ultrazohm/uz_d_resolver/docs/uz_d_resolver_pinning.docx

CH A/1 | Signal Adapter Board | Signalrichtung aus Sicht FPGA IP-Core | Dig_IO Adapter Board | CPLD – Adapter Board Pin D5 | CPLD – FPGA-Seite D5
| N_SAMPLE | Out | 00 | 47 | Dig_06_Ch5
| SDI | Out (MOSI) | 01 | 56 | Dig_07_Ch5
| F_SYNC | Out | 02 | 41 | Dig_08_Ch5
| SCLK | Out | 03 | 58 | Dig_09_Ch5
| \RESET | Out | 04 | 42 | Dig_10_Ch5
| A1 | Out | 05 | 59 | Dig_11_Ch5
| A0 | Out | 06 | 43 | Dig_12_Ch5
| CS | Out | 07 | 60 | Dig_13_Ch5
| SDO | In (MISO) | 08 | 44 | Dig_14_Ch5
CH B/2 | Signal | | Dig_IO Adapter Board | CPLD – Adapter Board Pin D5 | CPLD – FPGA-Seite D5
| N_SAMPLE | Out | 09 | 61 | Dig_15_Ch5
| SDI | Out (MOSI) | 10 | 84 | Dig_16_Ch5
| F_SYNC | Out | 11 | 64 | Dig_17_Ch5
| SCLK | Out | 12 | 85 | Dig_18_Ch5
| \RESET | Out | 13 | 65 | Dig_19_Ch5
| A1 | Out | 14 | 86 | Dig_20_Ch5
| A0 | Out | 15 | 66 | Dig_21_Ch5
| CS | Out | 16 | 87 | Dig_22_Ch5
| SDO | In (MISO) | 17 | 67 | Dig_23_Ch5
CH C/3 | Signal | | Dig_IO Adapter Board | CPLD – Adapter Board Pin D5 | CPLD – FPGA-Seite D5
| N_SAMPLE | Out | 18 | - | -
| SDI | Out (MOSI) | 19 | - | -
| F_SYNC | Out | 20 | - | -
| SCLK | Out | 21 | - | -
| \RESET | Out | 22 | - | -
| A1 | Out | 23 | - | -
| A0 | Out | 24 | - | -
| CS | Out | 25 | - | -
| SDO | In (MISO) | 26 | - | -
