ultrazohm/uz_d_resolver/Data_Sheets/CN0276-DesignSupport/EVAL-CN0276-SDPZ-BOM-RevA.xlsx

Title: | CN0276 Bill of Materials
Rev: | 0
Date: | 07/10/2013
Quantity | Reference Designator(s) | Value | Package | Manufacturer | Manufacturer Part Number | Nashua Part Number
2 | C1-2 | 33p | 2012 | KEMET | C0805C330J5GACTU | 7000831
4 | C3-4 C16-17 | 3.9n | 2012 | KOA | NPO0805HTTD3R9J | 7000222
4 | C5-6 C12-13 | 120p | 2012 | muRata | GRM2165C2A121JA01 | .
4 | C7-8 C14-15 | 680p | 2012 | AVX | 08055A681FAT2A | 7000186
1 | C10 | 10n | 2012 | AVX | 08051C103KAT2A | 7000032
6 | C11 C35 C40 C50 C52 C54 | 10u | 2012 | TDK | C2012X5R1V106M125AC | .
2 | C18 C32 | 470p | 2012 | muRata | GRM2165C2A471JA01 | .
2 | C21 C26 | 2.7n | 2012 | TDK | C2012C0G1H272J060AA | .
16 | C22-24 C30-31 C34 C36-37 C39 C41-42 C44-46 C51 C9 | 100n | 2012 | Yageo | CC0805KRX7R8BB104 | 7000758
1 | C38 | 100u | 7343 | AVX | TAJE107M025RNJ | .
2 | C25 C28 | 470u | 7343 | VISHAY | TR3D477M6R3C0200 | 7001327
2 | C20 C29 | 56p | 2012 | muRata | GRM21A5C2E560JW01D | .
2 | C33 C19 | 2.2n | 2012 | TDK | C2012C0G1H222J085AA | .
6 | C43 C27 C47-49 C53 | 1u | 2012 | AVX | 0805ZC105KAT2A | 7000264
2 | D1-2 |  | 2012 | Lumex | SML-LXT0805GW-TR | 7001182
1 | D3 |  | 2012 | Kingbright | APT2012QBC/D | .
1 | D4 |  | 2012 | Kingbright | APT2012SYCK | .
2 | D5-6 |  | 2012 | Avago | HSMS-C170 | 7001059
1 | J1 |  | FX8-120S-SV | HIROSE | FX8-120S-SV | 6000923
1 | J2 |  | IDC20 | Tyco Electronics | 2-1634688-0 | .
1 | J3 |  | 2510-6PIN | Tyco Electronics | 640456-6 | .
1 | J4 |  | 301-2PIN | Weidmüller | PM 5.08/02/90 | 6001003
1 | L1 | 1k | 2012 | TDK | MMZ2012R102A | .
4 | R1 R11 R24 R33 | 4.7k | 2012 | KOA | RK73B2ATTDD472J | 7000044
8 | R5 R2-3 R25-28 R4 | 27k | 2012 | VISHAY | CRCW080527K0FK | .
5 | R7 R6 R16 R47 R57 | 10k | 2012 | KOA | RK73B2ATTD103J | 7000039
1 | R13 | NP
4 | R14-15 R29 R32 | 2k | 2012 | VISHAY | CRCW08052K00FK | 7001433
4 | R30-31 R17-18 | 1.2k | 2012 | KOA | RK73B2ATTDD122J | 7000249
1 | R19 | 100k | 2012 | VISHAY | CRCW0805100KFK | .
5 | R20 R23 R12 R10 R58 | 0 | 2012 | Panasonic | ERJ-6GEY0R00V | 7000228
4 | R8-9 R21-22 | 22k | 2012 | KOA | RK73B2ATTDD223J | 7000095
6 | R34-39 | 1k | 2012 | Yageo | RC0805JR-071KL | 7000554
2 | R40 R56 | 3.3k | 2012 | VISHAY | CRCW08053K30FK | .
2 | R41 R54 | 750 | 2012 | KOA | RK73B2ATTDD751J | 7000162
2 | R43 R52 | 6.2k | 2012 | VISHAY | CRCW08056K20FK | .
2 | R45 R51 | 910 | 2012 | VISHAY | CRCW0805910RFK | .
2 | R46 R48 | 820 | 2012 | VISHAY | CRCW0805820RFK | .
1 | R49 | 390 | 2012 | VISHAY | CRCW0805390RFK | .
4 | R50 R44 R53 R42 | 20k | 2012 | VISHAY | CRCW080520K0FK | .
1 | R55 | 1.6k | 2012 | VISHAY | CRCW08051K60FK | .
1 | U1 |  | SOIC-8 | Microchip | 24LC32A-I/SN | 1000614
2 | U2 U5 |  | SOIC-14 | Analog Devices, Inc. | AD8694ARZ | .
1 | U3 |  | TSSOP-16 | Analog Devices, Inc. | ADG1611BRUZ | .
1 | U4 |  | LQFP-48 | Analog Devices, Inc. | AD2S1210BSTZ | .
1 | U6 |  | SOIC-8 | Analog Devices, Inc. | AD8692ARZ | .
1 | U7 |  | SOIC-EP-8 | Analog Devices, Inc. | AD8397ARDZ | 30-025792-01
1 | U8 |  | TSSOP-16 | Analog Devices, Inc. | ADG1612BRUZ | .
1 | U9 |  | SOT-23-3 | Analog Devices, Inc. | ADM6328-22ARTZ-R7 | .
1 | U10 |  | SOIC-EP-8 | Analog Devices, Inc. | ADP7104ARDZ-5.0-R7 | 30-026221-01
1 | U11 |  | SOIC-EP-8 | Analog Devices, Inc. | ADP7104ARDZ-3.3-R7 | 30-026222-01
1 | U12 |  | SOT-23-3 | VISHAY | SI2343CDS | 1000351
1 | Y1 | 8.192M | HCM49 | TXC | 9C-8.192MAAJ-T | .
