ultrazohm/uz_d_resolver/Data_Sheets/EVAL-AD2S1210_Design_Files/EVAL-AD2S1210SDZ BOM Rev B.xlsx

Analog Bill Of Materials for EVAL-AD2S1210SDZ RevB.pcb on 05-June-14
Name | Part Description | Value | Tolerance | PCB Decal | SMD | Layer Name | PART DESC | MFG #1 | Part Number | STOCK CODE
A | LED-0603-GREEN | GREEN |  | LED-0603 | Yes | Top | LED, SMD Green | OSRAM | LGQ971 | Digikey 475-1409-1-ND
B | LED-0603-GREEN | GREEN |  | LED-0603 | Yes | Top | LED, SMD Green | OSRAM | LGQ971 | Digikey 475-1409-1-ND
C1 | CAP | 120pF |  | 603 | Yes | Top | CAPACITOR, 0603, 120PF, 50V | YAGEO (PHYCOMP) | CC0603JRNPO9BN121 | FEC 722-091
C2 | CAP | 1uF 12mR | 0.1 | C0805 | Yes | Top | CAPACITOR CERAMIC, 1UF, 16V, X7R, 0805 | TAIYO YUDEN | EMK212B7105KD-T | FEC 1683651
C3 | CAP | 10nF | 0.05 | C0402 | Yes | Top | MLCC, 0402, X7R, 16V, 10NF | MULTICOMP | MCCA000040 | FEC 1758885
C4 | CAP+ | 10uF | ±10% | RTAJ_B | Yes | Top | 20V Tantalum Capacitor 10UF B-Size | Vishay Sprague | 293D106X9020B2TE3 | FEC 1754203
C5 | CAP | 0.1uF | ±10% | C0603 | Yes | Top | 50V X7R Ceramic Capacitor | Murata | GRM188R71H104KA93D | FEC 8820023
C6 | CAP | 120pF |  | 603 | Yes | Top | CAPACITOR, 0603, 120PF, 50V | YAGEO (PHYCOMP) | CC0603JRNPO9BN121 | FEC 722-091
C7 | CAP | 22pF | 0.05 | C0603 | Yes | Top | CAPACITOR, 0603, 22PF, 50V | Yageo | CC0603JRNPO9BN220 | FEC 722005
C8 | CAP | 22pF | 0.05 | C0603 | Yes | Top | CAPACITOR, 0603, 22PF, 50V | Yageo | CC0603JRNPO9BN220 | FEC 722005
C9 | CAP | 1uF 12mR | 0.1 | C0805 | Yes | Top | CAPACITOR CERAMIC, 1UF, 16V, X7R, 0805 | TAIYO YUDEN | EMK212B7105KD-T | FEC 1683651
C10 | CAP | 10nF | 0.05 | C0402 | Yes | Top | MLCC, 0402, X7R, 16V, 10NF | MULTICOMP | MCCA000040 | FEC 1758885
C11 | CAP | 10nF | 0.05 | C0402 | Yes | Top | MLCC, 0402, X7R, 16V, 10NF | MULTICOMP | MCCA000040 | FEC 1758885
C12 | CAP+ | 10uF | ±10% | RTAJ_B | Yes | Top | 20V Tantalum Capacitor 10UF B-Size | Vishay Sprague | 293D106X9020B2TE3 | FEC 1754203
C13 | CAP | 10nF | 0.05 | C0402 | Yes | Top | MLCC, 0402, X7R, 16V, 10NF | MULTICOMP | MCCA000040 | FEC 1758885
C14 | CAP+ | 10uF | ±10% | RTAJ_B | Yes | Top | 20V Tantalum Capacitor 10UF B-Size | Vishay Sprague | 293D106X9020B2TE3 | FEC 1754203
C15 | CAP | DNP | tba | C0805 | Yes | Top | SMD Capacitor footprint | n/a | n/a | Do Not Place
C16 | CAP | 10nF | 0.05 | C0402 | Yes | Top | MLCC, 0402, X7R, 16V, 10NF | MULTICOMP | MCCA000040 | FEC 1758885
C17 | CAP | 0.1uF | ±10% | C0603 | Yes | Top | 50V X7R Ceramic Capacitor | Murata | GRM188R71H104KA93D | FEC 8820023
C18 | CAP | 0.1uF | ±10% | C0603 | Yes | Top | 50V X7R Ceramic Capacitor | Murata | GRM188R71H104KA93D | FEC 8820023
C19 | CAP | 0.1uF | ±10% | C0603 | Yes | Top | 50V X7R Ceramic Capacitor | Murata | GRM188R71H104KA93D | FEC 8820023
C20 | CAP | 0.1uF | ±10% | C0603 | Yes | Top | 50V X7R Ceramic Capacitor | Murata | GRM188R71H104KA93D | FEC 8820023
C21 | CAP | 0.1uF | ±10% | C0603 | Yes | Top | 50V X7R Ceramic Capacitor | Murata | GRM188R71H104KA93D | FEC 8820023
C22 | CAP | 0.1uF | ±10% | C0603 | Yes | Top | 50V X7R Ceramic Capacitor | Murata | GRM188R71H104KA93D | FEC 8820023
C23 | CAP | 0.1UF | ±10% | C0603 | Yes | Top | 50V X7R Ceramic Capacitor | Murata | GRM188R71H104KA93D | FEC 8820023
C24 | CAP+ | 10uF | ±10% | RTAJ_B | Yes | Top | 20V Tantalum Capacitor 10UF B-Size | Vishay Sprague | 293D106X9020B2TE3 | FEC 1754203
C25 | CAP | 0.1uF | ±10% | C0603 | Yes | Top | 50V X7R Ceramic Capacitor | Murata | GRM188R71H104KA93D | FEC 8820023
C26 | CAP | 0.1uF | ±10% | C0603 | Yes | Top | 50V X7R Ceramic Capacitor | Murata | GRM188R71H104KA93D | FEC 8820023
C27 | CAP | DNP |  | C0805 | Yes | Top | SMD Capacitor footprint | n/a | n/a | Do Not Place
C28 | CAP | 10nF | 0.05 | C0402 | Yes | Top | MLCC, 0402, X7R, 16V, 10NF | Multicomp | MCCA000040 | FEC 1758885
C36 | CAP | 120pF |  | 603 | Yes | Top | CAPACITOR, 0603, 120PF, 50V | YAGEO (PHYCOMP) | CC0603JRNPO9BN121 | FEC 722-091
C37 | CAP | 120pF |  | 603 | Yes | Top | CAPACITOR, 0603, 120PF, 50V | YAGEO (PHYCOMP) | CC0603JRNPO9BN121 | FEC 722-091
C501 | CAP | 1uF 12mR | 0.1 | C0805 | Yes | Top | CAPACITOR CERAMIC, 1UF, 16V, X7R, 0805 | TAIYO YUDEN | EMK212B7105KD-T | FEC 1683651
C502 | CAP | 1uF 12mR | 0.1 | C0805 | Yes | Top | CAPACITOR CERAMIC, 1UF, 16V, X7R, 0805 | TAIYO YUDEN | EMK212B7105KD-T | FEC 1683651
C503 | CAP | 2u2F 14mR | 0.1 | C0805 | Yes | Top | CAPACITOR MLCC | TAIYO YUDEN | EMK212BJ225KG-T | FEC 1611955
C504 | CAP | 180pF | 5% | C0805 | Yes | Top | CAP CER 180PF 50V 5% NP0 0805 | Yageo | CC0805JRNP09BN181 | Digikey 311-1114-1-ND
C505 | CAP | 2n7F | 10% | C0805 | Yes | Top | MLCC, 0805, X7R, 50V, 2.7NF | MULTICOMP | MCCA000360 | FEC 1759237
C506 | CAP | 1uF | 0.1 | C0603 | Yes | Top | CAPACITOR, 0603, X5R, 10V, 1UF | MURATA | GRM188R61A105KA61D | FEC 1828798
C507 | CAP | 1uF | 0.1 | C0603 | Yes | Top | CAPACITOR, 0603, X5R, 10V, 1UF | MURATA | GRM188R61A105KA61D | FEC 1828798
C700 | CAP | 1uF 5.5mR | 10% | 1206 | Yes | Top | CAPACITOR, 1206, X7R, 50V, 1UF | MURATA | GRM31MR71H105KA88L | FEC 1828838
C701 | CAP | 10nF | 5% | C0402 | Yes | Top | MLCC, 0402, X7R, 16V, 10NF | MULTICOMP | MCCA000040 | FEC 1758885
C702 | CAP | 10nF | 5% | C0402 | Yes | Top | MLCC, 0402, X7R, 16V, 10NF | MULTICOMP | MCCA000040 | FEC 1758885
C703 | CAP | 10nF | 5% | C0402 | Yes | Top | MLCC, 0402, X7R, 16V, 10NF | MULTICOMP | MCCA000040 | FEC 1758885
C704 | CAP+ | 10UF | ±10% | RTAJ_B | Yes | Top | 20V Tantalum Capacitor 10UF B-Size | Vishay Sprague | 293D106X9020B2TE3 | FEC 1754203
C709 | CAP | 1uF | ±10% | C0805 | Yes | Top | CAPACITOR, 0805, 1UF, 50V, X7R | MURATA | GRM21BR71H105KA12L | FEC 1735541
C710 | CAP | DNP | n/a | C0402 | Yes | Top | 0402 Capacitor Location | n/a | n/a | Do Not Place
C711 | CAP+ | 10uF | ±10% | RTAJ_B | Yes | Top | 20V Tantalum Capacitor 10UF B-Size | Vishay Sprague | 293D106X9020B2TE3 | FEC 1754203
C712 | CAP+ | 10uF | ±10% | RTAJ_B | Yes | Top | 20V Tantalum Capacitor 10UF B-Size | Vishay Sprague | 293D106X9020B2TE3 | FEC 1754203
C713 | CAP | DNP | n/a | C0402 | Yes | Top | 0402 Capacitor Location | n/a | n/a | Do Not Place
C714 | CAP | DNP | n/a | C0402 | Yes | Top | 0402 Capacitor Location | n/a | n/a | Do Not Place
C715 | CAP | DNP | n/a | C0402 | Yes | Top | 0402 Capacitor Location | n/a | n/a | Do Not Place
C720 | CAP | 10nF | 5% | C0402 | Yes | Top | MLCC, 0402, X7R, 16V, 10NF | MULTICOMP | MCCA000040 | FEC 1758885
C721 | CAP | 1uF | ±10% | C0805 | Yes | Top | CAPACITOR, 0805, 1UF, 50V, X7R | Murata | GRM21BR71H105KA12L | FEC 1735541
C722 | CAP | 10nF | 5% | C0402 | Yes | Top | MLCC, 0402, X7R, 16V, 10NF | MULTICOMP | MCCA000040 | FEC 1758885
C723 | CAP | 10nF | 5% | C0402 | Yes | Top | MLCC, 0402, X7R, 16V, 10NF | MULTICOMP | MCCA000040 | FEC 1758885
C724 | CAP+ | 10uF 14mR | 20% | RTAJ_B | Yes | Top | CAPACITOR CERAMIC 10UF, 25V, X5R, 1206 | Taiyo Yuden | TMK316BJ106ML-T | FEC 2112857
C725 | CAP | 0.1uF | ±10% | C0603 | Yes | Top | 50V X7R Ceramic Capacitor | Murata | GRM188R71H104KA93D | FEC 8820023
CLKIN | SMB |  |  | SMB | No | Top | Straight PCB Mount SMB Jack - 50 Ohm | Tyco | 1-1337482-0 | Digikey J615-ND
D1 | DIODE |  |  | DIODE-0805 | Yes | Top | Small Signal Diode | Taiwan Semiconductor | TS4148 RY | FEC 815-0206
D2 | DIODE |  |  | DIODE-0805 | Yes | Top | Small Signal Diode | Taiwan Semiconductor | TS4148 RY | FEC 815-0206
D3 | DIODE |  |  | DIODE-0805 | Yes | Top | Small Signal Diode | Taiwan Semiconductor | TS4148 RY | FEC 815-0206
D4 | DIODE |  |  | DIODE-0805 | Yes | Top | Small Signal Diode | Taiwan Semiconductor | TS4148 RY | FEC 815-0206
D501 | MBRS130L | MBR130T1G | 0.05 | DO-214AA | Yes | Top | DIODE, SCHOTTKY, 1A, 30V, SOD-123 | ON SEMICONDUCTOR | MBR130T1G | FEC 1431045
D700 | DIODE-SCHOTTKY-30V-2A-B230A-13-F | 30V, 2A |  | DO-214AC | Yes | Top | DIODE,SCHOTTKY,30V,2A,SMA | DIODES INC. | B230A-13-F | FEC 1843686
D701 | ZENER-DIODE-MMSZ5245BT1G | BZT52 |  | SOD-123 | Yes | Top | DIODE, ZENER, 0.5W, 5.1V | VISHAY SEMICONDUCTOR | BZT52B5V1-V-GS08 | FEC 1617767
DIR | LED-0603-GREEN | GREEN |  | LED-0603 | Yes | Top | LED, SMD Green | OSRAM | LGQ971 | Digikey 475-1409-1-ND
DOS | LED-0603-GREEN | RED |  | LED-0603 | Yes | Top | LED, SMD Red | OSRAM | LSQ976 | Digikey 475-2512-2-ND
J2 | SDP-STANDARD-CONN |  |  | CON-120/FX8-120S-SV_W/S | No | Top | 120-way connector, 0.6mm pitch | Hirose | FX8-120S-SV(21) | FEC 1324660
J3 | HEADER26 |  |  | HEADER26 | No | Top | 26-Pin Header Location - Keep Holes free of solder | n/a | n/a | Do Not Insert
J4 | HEADER12 |  |  | HEADER12 | No | Top | 12 Pin (2x6) 0.1" Pitch Header | n/a | n/a | Do Not Insert
J5 | CON\POWER4 |  |  | CON\POWER4 | No | Top | TERMINAL BLOCK, PCB, 4WAY | LUMBERG | KRM 04 | FEC 1177877
J6 | CON\POWER |  |  | CON\POWER | No | Top | TERMINAL BLOCK, PCB, 2WAY | LUMBERG | KRM 02 | FEC 151785
J500 | CON\POWER |  |  | CON\POWER | No | Top | 2 Pin Terminal Block (5mm Pitch) | Camden | CTB5000/2 | FEC 151785
J701 | CON\POWER |  |  | CON\POWER | No | Top | 2 Pin Terminal Block (5mm Pitch) | Camden | CTB5000/2 | FEC 151785
J702 | CON\BARREL_SMD_2MM_KLDX-SMT2-0202-A |  |  | CON\BARREL_SMD_2MM_KLDX-SMT2-0202-A | No | Top | DC Power Connectors 2mm SMT POWER JACK | KYCON | KLDX-SMT2-0202-A | MOUSER 806-KLDX-SMT20202A
J703 | CON\POWER |  |  | CON\POWER | No | Top | 2 Pin Terminal Block (5mm Pitch) | Camden | CTB5000/2 | FEC 151785
J704 | CON\POWER |  |  | CON\POWER | No | Top | 2 Pin Terminal Block (5mm Pitch) | Camden | CTB5000/2 | FEC 151785
L501 | IND-6.8UH-LPS5030-682ML | 5.6uH | ±30% | IND-LPS5030-MODIFIED | Yes | Top | SMT power inductor 5.6 uH | Coilcraft | ME3220-562ML | Coilcraft ME3220-562MLB
L701 | IND-6.8UH-LPS5030-682ML | 6.8uH | ±30% | IND-LPS5030-MODIFIED | Yes | Top | CHOKE, POWER, 6X6X2MM, 6.8UH | PANASONIC | ELL6PG6R8N | FEC 1865660
LED702 | LED-0603-GREEN | GREEN |  | LED-0603 | Yes | Top | LED, SMD Green | OSRAM | LGQ971 | Digikey 475-1409-1-ND
LK1 | JUMPER-2 |  |  | LINK-2-R0603 | Yes | Top | 2 Way Link Option - Insert 0r in Position-B | Multicomp | MC 0.063W 0603 0R | FEC 9331662
LK2 | JUMPER-3 |  |  | LINK-3-R0603 | No | Top | 3 Way Link Option - Insert 0r in Position-C | Multicomp | MC 0.063W 0603 0R | FEC 9331662
LK3 | JUMPER-3 |  |  | LINK-3-R0603 | No | Top | 3 Way Link Option - Insert 0r in Position-C | Multicomp | MC 0.063W 0603 0R | FEC 9331662
LK4 | JUMPER-3 |  |  | JUMPER_3 | No | Top | 6 Pin (3x2) 0.1" Header & Shorting Block - Insert Shorting Block in Position-C | Harwin | M20-9983646 | FEC 1022244 & 150-411 (36 Pin Strip, Cut to Lenght)
LK5 | JUMPER-3 |  |  | JUMPER_3 | No | Top | 6 Pin (3x2) 0.1" Header & Shorting Block - Insert Shorting Block in Position-C | Harwin | M20-9983646 | FEC 1022244 & 150-411 (36 Pin Strip, Cut to Lenght)
LK6 | JUMPER-3 |  |  | JUMPER_3 | No | Top | 6 Pin (3x2) 0.1" Header & Shorting Block - Insert Shorting Block in Position-C | Harwin | M20-9983646 | FEC 1022244 & 150-411 (36 Pin Strip, Cut to Lenght)
LK7 | JUMPER-3 |  |  | JUMPER_3 | No | Top | 6 Pin (3x2) 0.1" Header & Shorting Block - Insert Shorting Block in Position-C | Harwin | M20-9983646 | FEC 1022244 & 150-411 (36 Pin Strip, Cut to Lenght)
LK9 | LINK-2-R0603 |  |  | LINK-2-R0603 | Yes | Top | 2 Way Link Option - Insert 0r in Position-A | Multicomp | MC 0.063W 0603 0R | FEC 9331662
LK10 | JUMPER-3 |  |  | JUMPER_3_INVTEXT | No | Top | 6 Pin (3x2) 0.1" Header & Shorting Block - Insert Shorting Block in Position-B | M20-9983646 | M20-9983646 | FEC 1022244 & 150-411 (36 Pin Strip, Cut to Lenght)
LK11 | JUMPER-3 |  |  | JUMPER_3_INVTEXT | No | Top | 6 Pin (3x2) 0.1" Header & Shorting Block - Insert Shorting Block in Position-B | Harwin | M20-9983646 | FEC 1022244 & 150-411 (36 Pin Strip, Cut to Lenght)
LK12 | JUMPER-3 |  |  | JUMPER_3_INVTEXT | No | Top | 6 Pin (3x2) 0.1" Header & Shorting Block - Insert Shorting Block in Position-B | Harwin | M20-9983646 | FEC 1022244 & 150-411 (36 Pin Strip, Cut to Lenght)
LK13 | JUMPER-3 |  |  | JUMPER_3_INVTEXT | No | Top | 6 Pin (3x2) 0.1" Header & Shorting Block - Insert Shorting Block in Position-B | Harwin | M20-9983646 | FEC 1022244 & 150-411 (36 Pin Strip, Cut to Lenght)
LK14 | JUMPER2\SIP3 |  |  | LINK-3P | No | Top | 3 Pin SIL Header & Shorting Link - Insert Shorting Block in Position-A | Harwin | M20-9990345 & M7567-05 | FEC 1022248 & 150410
LK15 | JUMPER2\SIP3 |  |  | LINK-3P | No | Top | 3 Pin SIL Header & Shorting Link - Insert Shorting Block in Position-A | Harwin | M20-9990345 & M7567-05 | FEC 1022248 & 150410
LK16 | JUMPER2\SIP3 |  |  | LINK-3P | No | Top | 3 Pin SIL Header & Shorting Link - Insert Shorting Block in Position-A | Harwin | M20-9990345 & M7567-05 | FEC 1022248 & 150410
LK17 | JUMPER2\SIP3 |  |  | LINK-3P | No | Top | 3 Pin SIL Header & Shorting Link - Insert Shorting Block in Position-A | Harwin | M20-9990345 & M7567-05 | FEC 1022248 & 150410
LK501 | JUMPER2\SIP3 |  |  | LINK-3P | No | Top | 3 Pin SIL Header & Shorting Link - Insert Shorting Block in Position-A | Harwin | M20-9990345 & M7567-05 | FEC 1022248 & 150410
LK701 | JUMPER2\SIP3 |  |  | LINK-3P | No | Top | 3 Pin SIL Header & Shorting Link - Insert Shorting Block in Position-A | Harwin | M20-9990345 & M7567-05 | FEC 1022248 & 150410
LK702 | JUMPER2\SIP3 |  |  | LINK-3P | No | Top | 3 Pin SIL Header & Shorting Link - Insert Shorting Block in Position-A | Harwin | M20-9990345 & M7567-05 | FEC 1022248 & 150410
LK703 | JUMPER2\SIP3 |  |  | LINK-3P | No | Top | 3 Pin SIL Header & Shorting Link - Insert Shorting Block in Position-A | Harwin | M20-9990345 & M7567-05 | FEC 1022248 & 150410
LOT | LED-0603-GREEN | RED |  | LED-0603 | Yes | Top | LED, SMD Red | OSRAM | LSQ976 | Digikey 475-2512-2-ND
NM | LED-0603-GREEN | GREEN |  | LED-0603 | Yes | Top | LED, SMD Green | OSRAM | LGQ971 | Digikey 475-1409-1-ND
Q1 | BC846B |  |  | SOT23 | Yes | Top | NPN Small signal Transistor | PHILIPS | BC846B | FEC 1081229
Q2 | BC856BLT1 |  |  | SOT23 | Yes | Top | PNP Small signal Transistor | PHILIPS | BC856B | FEC 1081243
Q3 | BC846B |  |  | SOT23 | Yes | Top | NPN Small signal Transistor | PHILIPS | BC846B | FEC 1081229
Q4 | BC856BLT1 |  |  | SOT23 | Yes | Top | PNP Small signal Transistor | PHILIPS | BC856B | FEC 1081243
Q5 | PDTB123ET |  |  | SC-59 | Yes | Top | NPN BRT TRANSISTOR, 50V, 10K/10KOHM, SC-59 | On Semiconductor | MUN2211T1G | FEC 1232166
Q6 | PDTB123ET |  |  | SC-59 | Yes | Top | NPN BRT TRANSISTOR, 50V, 10K/10KOHM, SC-59 | On Semiconductor | MUN2211T1G | FEC 1232166
Q7 | PDTB123ET |  |  | SC-59 | Yes | Top | NPN BRT TRANSISTOR, 50V, 10K/10KOHM, SC-59 | On Semiconductor | MUN2211T1G | FEC 1232166
Q8 | PDTB123ET |  |  | SC-59 | Yes | Top | NPN BRT TRANSISTOR, 50V, 10K/10KOHM, SC-59 | On Semiconductor | MUN2211T1G | FEC 1232166
Q9 | PDTB123ET |  |  | SC-59 | Yes | Top | NPN BRT TRANSISTOR, 50V, 10K/10KOHM, SC-59 | On Semiconductor | MUN2211T1G | FEC 1232166
Q10 | PDTB123ET |  |  | SC-59 | Yes | Top | NPN BRT TRANSISTOR, 50V, 10K/10KOHM, SC-59 | On Semiconductor | MUN2211T1G | FEC 1232166
Q11 | PDTB123ET |  |  | SC-59 | Yes | Top | NPN BRT TRANSISTOR, 50V, 10K/10KOHM, SC-59 | On Semiconductor | MUN2211T1G | FEC 1232166
Q12 | PDTB123ET |  |  | SC-59 | Yes | Top | NPN BRT TRANSISTOR, 50V, 10K/10KOHM, SC-59 | On Semiconductor | MUN2211T1G | FEC 1232166
Q501 | SI2304DDS-T1-GE3 |  |  | SOT23 | Yes | Top | MOSFET,N CH,30V,3.6A,DIODE,SOT23 | Vichay Siliconix | SI2304DDS-T1-GE3 | FEC 1858939
Q700 | NPN-BCX19 |  |  | SOT23 | Yes | Top | TRANSISTOR, NPN, SOT-23 | ON SEMICONDUCTOR | MMBT3904LT1G | FEC 1459100
Q701 | 2N7002 |  |  | SOT23 | Yes | Top | MOSFET N Transistor | STMICROELECTRONICS | 2N7002 | FEC 9512608
R1 | RES | 10K | 1% | R0603 | Yes | Top | RESISTOR, 10K, 0.063W, 1%, 0603 | MULTICOMP | MC 0.063W 0603 1% 10K | FEC 9330399
R2 | RES | 2k2 | 0.05 | R0603 | Yes | Top | RESISTOR, 0603 2K2 | MULTICOMP | MC 0.063W 0603 5% 2K2 | FEC 9331913
R3 | RES | 10k | 1% | R0603 | Yes | Top | RESISTOR, 10K, 0.063W, 1%, 0603 | MULTICOMP | MC 0.063W 0603 1% 10K | FEC 9330399
R4 | RES | 2k2 | 0.05 | R0603 | Yes | Top | RESISTOR, 0603 2K2 | Multicomp | MC 0.063W 0603 5% 2K2 | FEC 9331913
R5 | RES | 2k2 | 0.05 | R0603 | Yes | Top | RESISTOR, 0603 2K2 | MULTICOMP | MC 0.063W 0603 5% 2K2 | FEC 9331913
R6 | RES | 2k2 | 0.05 | R0603 | Yes | Top | RESISTOR, 0603 2K2 | Multicomp | MC 0.063W 0603 5% 2K2 | FEC 9331913
R7 | RES | 2k2 | 0.05 | R0603 | Yes | Top | RESISTOR, 0603 2K2 | Multicomp | MC 0.063W 0603 5% 2K2 | FEC 9331913
R8 | RES | 2k2 | 0.05 | R0603 | Yes | Top | RESISTOR, 0603 2K2 | MULTICOMP | MC 0.063W 0603 5% 2K2 | FEC 9331913
R9 | RES | 10K | 1% | 603 | Yes | Top | RESISTOR, 10K, 0.063W, 1%, 0603 | MULTICOMP | MC 0.063W 0603 1% 10K | FEC 9330399
R10 | RES | DNP |  | 603 | Yes | Top | 0603 Resistor footprint | n/a | n/a | Do Not Place
R11 | RES | DNP | n/a | R0603 | Yes | Top | 0603 Resistor footprint | n/a | n/a | Do Not Place
R12 | RES | 15k4 | 0.01 | 603 | Yes | Top | SMD Resistor | Multicomp | MC 0.063W 0603 1% 15K4 | FEC 117-0904
R13 | RES | 8K66 | 0.01 | 603 | Yes | Top | SMD Resistor | Multicomp | MC 0.063W 0603 1% 8K66 | FEC 117-0884
R14 | RES | 4R7 |  | 603 | Yes | Top | RESISTOR, 4R7, 0.063W, 1%, 0603 | MULTICOMP | MC0063W060314R7 | FEC 9331280
R15 | RES | 2K2 |  | R0603 | Yes | Top | RESISTOR, 0603 2K2 | MULTICOMP | MC 0.063W 0603 5% 2K2 | FEC 9331913
R16 | RES | 3R3 |  | 603 | Yes | Top | RESISTOR, 3R3, 0.063W, 1%, 0603 | MULTICOMP | MC0063W060313R3 | FEC 9331069
R17 | RES | 10k | 1% | R0603 | Yes | Top | RESISTOR, 10K, 0.063W, 1%, 0603 | MULTICOMP | MC 0.063W 0603 1% 10K | FEC 9330399
R18 | RES | 2K2 |  | R0603 | Yes | Top | RESISTOR, 0603 2K2 | MULTICOMP | MC 0.063W 0603 5% 2K2 | FEC 9331913
R19 | RES | DNP |  | 603 | Yes | Top | 0603 Resistor footprint | n/a | n/a | Do Not Place
R20 | RES | 15k4 | 0.01 | 603 | Yes | Top | SMD Resistor | Multicomp | MC 0.063W 0603 1% 15K4 | FEC 117-0904
R21 | RES | DNP | DNI | R0603 | Yes | Top | 0603 Resistor footprint | n/a | n/a | Do Not Place
R22 | RES | DNP | DNI | R0603 | Yes | Top | 0603 Resistor footprint | n/a | n/a | Do Not Place
R23 | RES | 0R | 0.01 | R0805 | Yes | Top | RESISTOR, 0805 0R0,0.1W | Multicomp | MC 0.1W 0805 0R | FEC 9333681
R24 | RES | 0R | 0.01 | R0805 | Yes | Top | RESISTOR, 0805 0R0,0.1W | Multicomp | MC 0.1W 0805 0R | FEC 9333681
R25 | RES | 0R | 0.01 | R0805 | Yes | Top | RESISTOR, 0805 0R0,0.1W | Multicomp | MC 0.1W 0805 0R | FEC 9333681
R26 | RES | 0R | 0.01 | R0805 | Yes | Top | RESISTOR, 0805 0R0,0.1W | Multicomp | MC 0.1W 0805 0R | FEC 9333681
R27 | RES | 8K66 | 0.01 | 603 | Yes | Top | SMD Resistor | Multicomp | MC 0.063W 0603 1% 8K66 | FEC 117-0884
R28 | RES | 100K | 0.01 | R0603 | Yes | Top | SMD Resistor | Multicomp | MC 0.063W 0603 1% 100K | FEC 9330402
R29 | RES | 100K | 0.01 | R0603 | Yes | Top | SMD Resistor | Multicomp | MC 0.063W 0603 1% 100K | FEC 9330402
R30 | RES | DNP |  | 603 | Yes | Top | 0603 Resistor footprint | n/a | n/a | Do Not Place
R31 | RES | 15k4 | 0.01 | 603 | Yes | Top | SMD Resistor | Multicomp | MC 0.063W 0603 1% 15K4 | FEC 117-0904
R32 | RES | 8K66 | 0.01 | 603 | Yes | Top | SMD Resistor | Multicomp | MC 0.063W 0603 1% 8K66 | FEC 117-0884
R39 | RES | DNP |  | 603 | Yes | Top | 0603 Resistor footprint | n/a | n/a | Do Not Place
R40 | RES | 15k4 | 0.01 | 603 | Yes | Top | SMD Resistor | Multicomp | MC 0.063W 0603 1% 15K4 | FEC 117-0904
R41 | RES | 8K66 | 0.01 | 603 | Yes | Top | SMD Resistor | Multicomp | MC 0.063W 0603 1% 8K66 | FEC 117-0884
R42 | RES | 10K | 1% | 603 | Yes | Top | RESISTOR, 10K, 0.063W, 1%, 0603 | MULTICOMP | MC 0.063W 0603 1% 10K | FEC 9330399
R44 | RES | 3R3 |  | 603 | Yes | Top | RESISTOR, 3R3, 0.063W, 1%, 0603 | MULTICOMP | MC0063W060313R3 | FEC 9331069
R45 | RES | 68k | 0.01 | R0603 | Yes | Top | Resistor | MULTICOMP | MC 0.063W 0603 1% 68K | FEC 9331468
R46 | RES | DNP | 0.01 | R0603 | Yes | Top | 0603 Resistor footprint | n/a | n/a | Do Not Place
R47 | RES | 4R7 |  | 603 | Yes | Top | RESISTOR, 4R7, 0.063W, 1%, 0603 | MULTICOMP | MC0063W060314R7 | FEC 9331280
R48 | RES | 4R7 |  | 603 | Yes | Top | RESISTOR, 4R7, 0.063W, 1%, 0603 | MULTICOMP | MC0063W060314R7 | FEC 9331280
R49 | RES | 10k | 1% | R0603 | Yes | Top | RESISTOR, 10K, 0.063W, 1%, 0603 | MULTICOMP | MC 0.063W 0603 1% 10K | FEC 9330399
R50 | RES | 0r | 0.01 | R0603 | Yes | Top | RESISTOR, 0603, 0R, 0.063W | Multicomp | MC 0.063W 0603 0R | FEC 933-1662
R51 | RES | DNP | 0.01 | R0603 | Yes | Top | 0603 Resistor footprint | n/a | n/a | Do Not Place
R52 | RES | 10k | 1% | R0603 | Yes | Top | RESISTOR, 10K, 0.063W, 1%, 0603 | MULTICOMP | MC 0.063W 0603 1% 10K | FEC 9330399
R53 | RES | 0r | 0.01 | R0603 | Yes | Top | RESISTOR, 0603, 0R, 0.063W | Multicomp | MC 0.063W 0603 0R | FEC 933-1662
R54 | RES | DNP | 0.01 | R0603 | Yes | Top | 0603 Resistor footprint | n/a | n/a | Do Not Place
R55 | RES | DNP | 0.01 | R0603 | Yes | Top | 0603 Resistor footprint | n/a | n/a | Do Not Place
R56 | RES | DNP | 0.01 | R0603 | Yes | Top | 0603 Resistor footprint | n/a | n/a | Do Not Place
R57 | RES | 0R | 0.01 | R0603 | Yes | Top | RESISTOR, 0603, 0R, 0.063W | Multicomp | MC 0.063W 0603 0R | FEC 933-1662
R58 | RES | 0r | 0.01 | R0603 | Yes | Top | RESISTOR, 0603, 0R, 0.063W | Multicomp | MC 0.063W 0603 0R | FEC 933-1662
R59 | RES | 0R | 0.01 | R0603 | Yes | Top | RESISTOR, 0603, 0R, 0.063W | Multicomp | MC 0.063W 0603 0R | FEC 933-1662
R60 | RES | DNP | 0.01 | R0603 | Yes | Top | 0603 Resistor footprint | n/a | n/a | Do Not Place
R61 | RES | DNP | 0.01 | R0603 | Yes | Top | 0603 Resistor footprint | n/a | n/a | Do Not Place
R62 | RES | 0R | 0.01 | R0603 | Yes | Top | RESISTOR, 0603, 0R, 0.063W | Multicomp | MC 0.063W 0603 0R | FEC 933-1662
R63 | RES | 0R | 0.01 | R0603 | Yes | Top | RESISTOR, 0603, 0R, 0.063W | Multicomp | MC 0.063W 0603 0R | FEC 933-1662
R64 | RES | DNP | 0.01 | R0603 | Yes | Top | 0603 Resistor footprint | n/a | n/a | Do Not Place
R65 | RES | 2K2 |  | R0603 | Yes | Top | RESISTOR, 0603 2K2 | MULTICOMP | MC 0.063W 0603 5% 2K2 | FEC 9331913
R66 | RES | 2K2 |  | R0603 | Yes | Top | RESISTOR, 0603 2K2 | MULTICOMP | MC 0.063W 0603 5% 2K2 | FEC 9331913
R67 | RES | 3R3 |  | 603 | Yes | Top | RESISTOR, 3R3, 0.063W, 1%, 0603 | MULTICOMP | MC0063W060313R3 | FEC 9331069
R68 | RES | 3R3 |  | 603 | Yes | Top | RESISTOR, 3R3, 0.063W, 1%, 0603 | MULTICOMP | MC0063W060313R3 | FEC 9331069
R74 | RES | 22K | 0.01 | R0603 | Yes | Top | RESISTOR, 22K, 0.063W, 1% | MULTICOMP | MC 0.063W 0603 1% 22K | FEC 9330828
R75 | RES | 10K | 1% | R0603 | Yes | Top | RESISTOR, 10K, 0.063W, 1%, 0603 | MULTICOMP | MC 0.063W 0603 1% 10K | FEC 9330399
R76 | RES | DNP | n/a | R0603 | Yes | Top | 0603 Resistor footprint | n/a | n/a | Do Not Place
R113 | RES | 4R7 |  | 603 | Yes | Top | RESISTOR, 4R7, 0.063W, 1%, 0603 | MULTICOMP | MC0063W060314R7 | FEC 9331280
R147 | RES | 0R | 0.01 | R0603 | Yes | Top | RESISTOR, 0603, 0R, 0.063W | Multicomp | MC 0.063W 0603 0R | FEC 933-1662
R148 | RES | 10k | 1% | R0603 | Yes | Top | RESISTOR, 10K, 0.063W, 1%, 0603 | MULTICOMP | MC 0.063W 0603 1% 10K | FEC 9330399
R165 | RES | DNP | 0.01 | R0603 | Yes | Top | 0603 Resistor footprint | n/a | n/a | Do Not Place
R501 | RES | 33mR | 0.02 | R0805 | Yes | Top | RESISTOR, CUR SENSE, 0.033OHM, 250mW, 2% | SUSUMU | RL1220T-R033-G | FEC 9376739
R502 | RES | 768R | 1% | R0805 | Yes | Top | RES 768 OHM 1/8W 1% 0805 SMD | Yageo | RC0805FR-07768RL | Digikey 311-768CRCT-ND
R503 | RES | 24k9 | 1% | R0805 | Yes | Top | RES 24.9K OHM 1/8W 1% 0805 SMD | Yageo | RC0805FR-0724K9L | Digikey 311-24.9KCRCT-ND
R504 | RES | 3k65 | 1% | R0805 | Yes | Top | RES 3.65K OHM 1/8W 1% 0805 SMD | Yageo | RC0805FR-073K65L | Digikey 311-3.65KCRCT-ND
R505 | RES | 75k | 0.01 | R0805 | Yes | Top | RESISTOR, 0805 75K | MULTICOMP | MC 0.1W 0805 1% 75K | FEC 9333541
R506 | RES | 8K45 | 0.01 | R0805 | Yes | Top | RESISTOR, THICK FILM, 8.45KOHM, 125mW, 1% | Vishay/Dale | CRCW08058K45FKEA | FEC 1270592
R507 | RES | 536R | 1% | R0805 | Yes | Top | RES 536 OHM 1/8W 1% 0805 SMD | Stackpole Electronics Inc | RMCF0805FT536R | Digikey RMCF0805FT536RCT-ND
R508 | RES | 1k54 | 1% | R0805 | Yes | Top | RES 1.54K OHM 1/8W 1% 0805 SMD | Yageo | RC0805FR-071K54L | Digikey 311-1.54KCRCT-ND
R509 | RES | 0R | 0.01 | R0805 | Yes | Top | RESISTOR, 0805 0R0,0.1W | Multicomp | MC 0.1W 0805 0R | FEC 9333681
R700 | RES0603 | 330k | 5% | R0402 | Yes | Top | RESISTOR, RC31 0402 330K | YAGEO (PHYCOMP) | RC0402JR-07330KL | FEC 9233067
R701 | RES | 68k | 5% | R0402 | Yes | Top | RESISTOR, 0402, 1%, 68K | YAGEO (PHYCOMP) | RC0402JR-0768KL | FEC 9232982
R702 | RES | 18k | 5% | R0402 | Yes | Top | RESISTOR, RC31 0402 18K | YAGEO (PHYCOMP) | RC0402JR-0718KL | FEC 9232915
R703 | RES | 68k | 5% | R0402 | Yes | Top | RESISTOR, 0402, 1%, 68K | YAGEO (PHYCOMP) | RC0402JR-0768KL | FEC 9232982
R704 | RES | 68k | 5% | R0402 | Yes | Top | RESISTOR, 0402, 1%, 68K | YAGEO (PHYCOMP) | RC0402JR-0768KL | FEC 9232982
R705 | RES | 18k | 5% | R0402 | Yes | Top | RESISTOR, RC31 0402 18K | YAGEO (PHYCOMP) | RC0402JR-0718KL | FEC 9232915
R706 | RES | 18k | 5% | R0402 | Yes | Top | RESISTOR, RC31 0402 18K | YAGEO (PHYCOMP) | RC0402JR-0718KL | FEC 9232915
R707 | RES | 68k | 5% | R0402 | Yes | Top | RESISTOR, 0402, 1%, 68K | YAGEO (PHYCOMP) | RC0402JR-0768KL | FEC 9232982
R708 | RES | 18k | 5% | R0402 | Yes | Top | RESISTOR, RC31 0402 18K | YAGEO (PHYCOMP) | RC0402JR-0718KL | FEC 9232915
R709 | RES | 61R9 | 1% | R0402 | Yes | Top | RESISTOR, 0402, 1%, 61R9 | MULTICOMP | MC 0.0625W 0402 1% 61R9 | FEC 1802915
R710 | RES | 470R | 5% | R0402 | Yes | Top | RESISTOR, 0402, 470R, 0,5% | YAGEO (PHYCOMP) | RE0402DR-07470RL | FEC 1840545
R711 | RES | 10k2 | 1% | R0402 | Yes | Top | SMD Resistor | Multicomp | MC 0.0625W 0402 1% 10K2 | FEC 1803137
R712 | RES0603 | 330k | 5% | R0402 | Yes | Top | RESISTOR, RC31 0402 330K | YAGEO (PHYCOMP) | RC0402JR-07330KL | FEC 9233067
R713 | RES | 2k4 | 1% | R0603 | Yes | Top | RESISTOR, THICK FILM, 2.4KOHM, 0603, 100mW, 1% | YAGEO | RC0603FR-072K4L | FEC 1799329
R714 | RES | 53k6 | 1% | R0402 | Yes | Top | SMD Resistor | Multicomp | MC 0.0625W 0402 1% 53K6 | FEC 1803723
R716 | RES | 10k | 1% | R0402 | Yes | Top | RESISTOR, 10K, 0.063W, 1%, 0402 | MULTICOMP | MC00625W0402110K | FEC 1358069
R717 | RES | 10k | 1% | R0402 | Yes | Top | RESISTOR, 10K, 0.063W, 1%, 0402 | MULTICOMP | MC00625W0402110K | FEC 1358069
R718 | RES | 10k | 1% | R0402 | Yes | Top | RESISTOR, 10K, 0.063W, 1%, 0402 | MULTICOMP | MC00625W0402110K | FEC 1358069
R719 | RES | 10k | 1% | R0402 | Yes | Top | RESISTOR, 10K, 0.063W, 1%, 0402 | MULTICOMP | MC00625W0402110K | FEC 1358069
RESET | SW-PUSH-SMD |  |  | SW_PB_SMD_6MM | Yes | Top | SMD Push Button Switch (sealed 6mm x 6mm) | Omron | B3S-1000 | FEC 177-807
S2 | SW-PUSH-SMD |  |  | SW_PB_SMD_6MM | Yes | Top | SMD Push Button Switch (sealed 6mm x 6mm) | Omron | B3S-1000 | FEC 177-807
S3 | SW-PUSH-SMD |  |  | SW_PB_SMD_6MM | Yes | Top | SMD Push Button Switch (sealed 6mm x 6mm) | Omron | B3S-1000 | FEC 177-807
T_AGND | TESTPOINT | Red |  | TESTPOINT | No | Top | TERMINAL, PCB, RED, PK100 | VERO | 20-313137 | FEC 8731144
T_COS | TESTPOINT | Red |  | TESTPOINT | No | Top | TERMINAL, PCB, RED, PK100 | VERO | 20-313137 | FEC 8731144
T_COSLO | TESTPOINT | Red |  | TESTPOINT | No | Top | TERMINAL, PCB, RED, PK100 | VERO | 20-313137 | FEC 8731144
T_DGND | TESTPOINT | Red |  | TESTPOINT | No | Top | TERMINAL, PCB, RED, PK100 | VERO | 20-313137 | FEC 8731144
T_EXC | TESTPOINT | Red |  | TESTPOINT | No | Top | TERMINAL, PCB, RED, PK100 | VERO | 20-313137 | FEC 8731144
T_EXC_OUT | TESTPOINT | Red |  | TESTPOINT | No | Top | TERMINAL, PCB, RED, PK100 | VERO | 20-313137 | FEC 8731144
T_REFOUT | TESTPOINT | Red |  | TESTPOINT | No | Top | TERMINAL, PCB, RED, PK100 | VERO | 20-313137 | FEC 8731144
T_SIN | TESTPOINT | Red |  | TESTPOINT | No | Top | TERMINAL, PCB, RED, PK100 | VERO | 20-313137 | FEC 8731144
T_SINLO | TESTPOINT | Red |  | TESTPOINT | No | Top | TERMINAL, PCB, RED, PK100 | VERO | 20-313137 | FEC 8731144
T_\EXC | TESTPOINT | Red |  | TESTPOINT | No | Top | TERMINAL, PCB, RED, PK100 | VERO | 20-313137 | FEC 8731144
T_\EXC_OUT | TESTPOINT | Red |  | TESTPOINT | No | Top | TERMINAL, PCB, RED, PK100 | VERO | 20-313137 | FEC 8731144
U1 | AD2S1210DSTZ |  |  | LQFP48 | Yes | Top | 10-16-Bit R/D Converter | Analog Devices | AD2S1210DSTZ | AD2S1210DSTZ
U2 | 24LC32A-I/MS |  |  | MSO8 | Yes | Top | 32K I2C Serial EEPROM, MSOP8 | Microchip | 24LC32A-I/MS | FEC 1331330
U3 | ADG3308BRUZ |  |  | TSSOP20 | Yes | Top | Bidirectional Logic Level Translator | Analog Devices | ADG3308BRUZ | ADG3308BRUZ
U4 | AD8397ARMZ |  |  | SO8NB | Yes | Top | Dual Op-Amp | Analog Devices | AD8397ARZ | AD8397ARZ
U5 | ADG3308BRUZ |  |  | TSSOP20 | Yes | Top | Bidirectional Logic Level Translator | Analog Devices | ADG3308BRUZ | ADG3308BRUZ
U8 | ADM811 |  |  | SOT143 | Yes | Top | Voltage Monitor | Analog Devices | ADM811-3TARTZ | ADM811-3TARTZ
U9 | AD8662 |  |  | SO8NB | Yes | Top | DUAL OP Amp | Analog Devices | AD8662ARZ | AD8662ARZ
U11 | ADG3308BRUZ |  |  | TSSOP20 | Yes | Top | Bidirectional Logic Level Translator | Analog Devices | ADG3308BRUZ | ADG3308BRUZ
U501 | ADP1621 |  |  | MSO10 | Yes | Top | Constant-Frequency, Current-Mode Step-Up DC/DC Controller | Analog Devices | ADP1621ARMZ | ADP1621ARMZ
U700 | ADP3303-5 |  |  | SO8NB | Yes | Top | Precision Low Dropout Voltage Regulator | Analog Devices | ADP3303AR-5 | ADI ADP3303ARZ-5
U703 | ADM1185ARMZ |  |  | MSO10 | Yes | Top | Quad Voltage Monitor and Sequencer | Analog Devices | ADM1185ARMZ-1 | ADI ADM1185ARMZ-1
U704 | ADP3303-5 |  |  | SO8NB | Yes | Top | Precision Low Dropout Voltage Regulator | Analog Devices | ADP3303AR-5 | ADI ADP3303ARZ-5
U705 | ADP2301AUJZ |  |  | TSOT-6 | Yes | Top | 1.2 A, 20 V, 1.4 MHz non-synchronous Step-down Switching Regulator | Analog Devices | ADP2301AUJZ | ADI ADP2301AUJZ-R7
X1 | CLAMP-7MM |  |  | CLAMP-7MM | No | Top | 7mm QFP Clamp | IM Tech | CLAMP-7MM | Do Not Insert
Y1 | XTAL1 | 8.192MHz |  | XTAL-UM1 | No | Top | Crystal | AEL | X8M192000L123 | FEC 9509453
Screw1 |  | ** |  |  |  |  | SCREW, CHEESE, NYLON, M3X10, PK100 | ALLTHREAD | 119030010 | FEC 7070597
Screw2 |  | ** |  |  |  |  | SCREW, CHEESE, NYLON, M3X10, PK100 | ALLTHREAD | 119030010 | FEC 7070597
Nut1 |  | ** |  |  |  |  | NUT/WASHER, NYLON, M3, PK100 | DURATOOL | 1140030 | FEC 7061857
Nut2 |  | ** |  |  |  |  | NUT/WASHER, NYLON, M3, PK100 | DURATOOL | 1140030 | FEC 7061857
 | Distributor Web Sites |  |  |  |  | Parts Not Inserted
 | FEC | www.farnell.com |  |  |  | ADI Supplied Parts
 | Digikey | www.digikey.com |  |  |  | Changes since last Rev
 | Analog Devices | www.analog.com |  |  |  | Bare Board |  | EVAL-AD2S1210SDZ RevB
 | Anixter Comps | www.anixtercomponents.com |  |  |  | 4 x Stick on feet - height must be greater than component height on Bottom side Do Not Cover Mounting holes with Feet. |  | 3M | SJ5008BLACK | FEC 1165072
 | Coilcraft | www.coilcraft.com |  |  |  | Packing Material |  |  |  | Bubble Wrap
 |  |  |  |  |  | Board to be placed in suitable sized Anti-static bag
 |  |  |  |  |  | Eval Kit Box - Large |  |  |  | ADLK Stores 64005043
 |  |  |  |  |  | 9Vdc 2Amp Plug & Go 18 Watt Interchangeable SMPSU |  | Stontronics | T4817ST | ADI 22001001
 |  |  |  |  |  | Distribution CD - check latest revision |  |  |  | ADI Issue
 |  |  |  |  |  | BOX LABELS |  | Part No: EVAL-AD2S1210SDZ Description: AD2S1210SDZ Evaluation Kit |  | ADI Issue
** Fit both screws from the opposite side of the board to the 120-way connector, into the two associated connector mounting holes and fix securely in place with nuts .
