ultrazohm/uz_d_resolver/Project Outputs for UZ_D_Resolver/Rev02/BOM/BOM_JLC-UZ_D_Resolver_August_2024.xlsx

Quantity | Comment | Designator | Manufacturer | Value | Description | Footprint | Voltage | Dielectric | Manufacturer Part Number | LCSC Part Number
12 | 4.7 µF | C1A, C1B, C1C, C6A, C6B, C6C, C8A, C8B, C8C, C9A, C9B, C9C | muRata | 4.7 µF | Capacitor 0603, 35 VDC, 4.7 µF, X5R | C_0603 |  |  | GRM188R6YA475KE15D | C19666
12 | 10 nF | C2A, C2B, C2C, C5A, C5B, C5C, C7A, C7B, C7C, C10A, C10B, C10C | FH (Guangdong Fenghua Advanced Tech) | 10 nF | 50V 10nF X7R ±10% 0603 Multilayer Ceramic Capacitors MLCC - SMD/SMT ROHS | C_0603 |  |  | 0603B103K500NT | C57112
1 | 100 nF | C3 | KEMET | 100 nF | Capacitor 0603, 6.3 VDC, 100 nF, X5R | C_0603 |  |  | C0603C104K9PACTU | C14663
12 | 100 nF | C4A, C4B, C4C, C12A, C12B, C12C, C24A, C24B, C24C, C29A, C29B, C29C | YAGEO | 100 nF | Capacitor 0603, 50 VDC, 100 nF, X7R | C_0603 |  |  | CC0603KRX7R9BB104 | C14663
9 | 2.2uF | C11A, C11B, C11C, C13A, C13B, C13C, C30A, C30B, C30C |  | 2.2uF | Capacitor | RES_1206 | 50V |  |  | C50254
18 | 100 pF | C14A, C14B, C14C, C15A, C15B, C15C, C16A, C16B, C16C, C17A, C17B, C17C, C18A, C18B, C18C, C19A, C19B, C19C | Samsung Electro-Mechanics | 100 pF | 50V 100pF C0G ±5% 0603 Multilayer Ceramic Capacitors MLCC - SMD/SMT ROHS | C_0603 |  |  | CL10C101JB8NNNC | C14858
24 | 1 nF | C20A, C20B, C20C, C21A, C21B, C21C, C22A, C22B, C22C, C23A, C23B, C23C, C25A, C25B, C25C, C26A, C26B, C26C, C27A, C27B, C27C, C28A, C28B, C28C | YAGEO | 1 nF | Capacitor 0603, 50 VDC, 1 nF, NP0 | C_0603 |  |  | CC0603JRNPO9BN102 | C106246
1 | 19-217/BHC-ZL1M2RY/3T | D1 | Everlight Elec |  | LED BLUE 465~475NM 11.5~28.5MCD@5MA TOP VIEW 0603 ROHS | WL-SMCW_0603 |  |  | 19-217/BHC-ZL1M2RY/3T | C434421
3 | KT-0603R | D2A, D2B, D2C | Hubei KENTO Elec |  | LED RED 520~625NM 90~100MCD@20MA TOP VIEW 0603 ROHS | WL-SMCW_0603 |  |  | KT-0603R | C2286
3 | 19-217/GHC-YR1S2/3T | D3A, D3B, D3C | Everlight Elec |  | LED GREEN 520~535NM 112~258MCD@20MA TOP VIEW 0603 ROHS | WL-SMCW_0603 |  |  | 19-217/GHC-YR1S2/3T | C72043
6 | BAV99,235 | D4A, D4B, D4C, D5A, D5B, D5C |  |  | DIODE ARRAY GP 100V 215MA SOT23 | SOT-23 |  |  |  | C2500
12 | SBAS70-04LT1G | D6A, D6B, D6C, D7A, D7B, D7C, D8A, D8B, D8C, D9A, D9B, D9C |  |  | DIODE SCHOTTKY 70V DUAL SOT23 | SOT-23 |  |  |  | C389351
7 | Littelfuse_PTC_1812 | F1, F2A, F2B, F2C, F3A, F3B, F3C | Littelfuse | PTC, 1.1 A, 24V | POLYSWITCH RESETTABLE DEVICES | 1812_PTC_Polyfuse_Littelfuse | 24V |  | Littelfuse_PTC_1812 | C70119
6 | UPZ2012E601-2R0TF | L1A, L1B, L1C, L2A, L2B, L2C | Sunlord | 90 Ohm | 2A 1 90mΩ 600Ω@100MHz ±25% 0805 Ferrite Beads ROHS | INDC2012X92N_V |  |  | UPZ2012E601-2R0TF | C98308
6 | BC846BLT3G | Q1A, Q1B, Q1C, Q3A, Q3B, Q3C |  |  | NPN Bipolar Transistor | SOT-23 |  |  |  | C513271
6 | BC856B,215 | Q2A, Q2B, Q2C, Q4A, Q4B, Q4C |  |  | PNP Bipolar Transistor | SOT-23 |  |  |  | C109310
9 | 0R | R2, R50A, R50B, R50C, R52A, R52B, R52C, R53, R54 | YAGEO | 0R | SMD resistor E24 series | RES 0603_1608 |  |  | RC0603JR-070RL | C21189
4 | 22k | R6, R24A, R24B, R24C | KOA Speer | 22k | SMD resistor E24 series | RES 0603_1608 |  |  | RK73B1JTTD223J | C31850
33 | 10k | R8A, R8B, R8C, R9A, R9B, R9C, R12A, R12B, R12C, R13A, R13B, R13C, R16A, R16B, R16C, R18A, R18B, R18C, R20A, R20B, R20C, R21A, R21B, R21C, R25A, R25B, R25C, R26A, R26B, R26C, R27A, R27B, R27C | KOA Speer | 10k | SMD resistor E24 series | RES 0603_1608 |  |  | RK73B1JTTD103J | C25804
17 | 4k7 | R22A, R22B, R22C, R46A, R46B, R46C, R47A, R47B, R47C, R48A, R48B, R48C, R49A, R49B, R49C, R55, R56, R57 | UNI-ROYAL | 4k7 | SMD resistor E24 series | RES 0603_1608 |  |  | 0603WAF4701T5E | C23162
15 | 2k2 | R23A, R23B, R23C, R30A, R30B, R30C, R33A, R33B, R33C, R34A, R34B, R34C, R37A, R37B, R37C | KOA Speer | 2k2 | SMD resistor E24 series | RES 0603_1608 |  |  | RK73B1JTTD222J | C4190
6 | 15k | R28A, R28B, R28C, R29A, R29B, R29C | KOA Speer | 15k | SMD resistor E24 series | RES 0603_1608 |  |  | RK73B1JTTD153J | C22809
12 | 3.3R | R31A, R31B, R31C, R32A, R32B, R32C, R35A, R35B, R35C, R36A, R36B, R36C | KOA Speer | 3.3R | SMD resistor E24 series | RES 0603_1608 |  |  | RK73B1JTTDD3R3J | C25238
12 | 4.7R | R38A, R38B, R38C, R39A, R39B, R39C, R40A, R40B, R40C, R41A, R41B, R41C | KOA Speer | 4.7R | SMD resistor E24 series | RES 0603_1608 |  |  | RK73B1JTTDD4R7J | C23164
12 | 100R | R42A, R42B, R42C, R43A, R43B, R43C, R44A, R44B, R44C, R45A, R45B, R45C | KOA Speer | 100R | SMD resistor E24 series | RES 0603_1608 |  |  | RK73B1JTTD101J | C22775
2 | 100k | R59, R60 | KOA Speer | 100k | SMD resistor E24 series | RES 0603_1608 |  |  | RK73B1JTTD104J | C25803
1 | Serial # | Serial | PCB Manufacturer |  | Field to put in a serial number | SERIAL |  |  | Serial Number |  | old part
3 | AD2S1210 | U1A, U1B, U1C |  | AD2S1210WDSTZRL7 | Variable Resolution, 10-Bit to 16-Bit R/D Converter with Reference Oscillator | LQFP-48_L |  |  |  | C459871 | C408404 | AD2S1210BSTZ | von Hand geändert!
3 | PDSE1-S24-S12-M-TR CUI INC. | U2A, U2B, U2C |  |  | DC DC CONVERTER 12V 1W | DC/DC 24V-->12V 1W Aislado |  |  |  | C6730719
3 | AD8662ARZ | U3A, U3B, U3C |  |  | IC OPAMP GP 2 CIRCUIT 14SOIC | SOIC8_N |  |  |  | C28133
3 | LT1639HS#PBF | U4A, U4B, U4C |  |  | IC OPAMP GP 4 CIRCUIT 14SO | SOIC-14 |  |  |  | C664522 | C579803 | LT1639CS#PBF
1 | M24C02-WMN6TP | U5 | STMicroelectronics | M24C02-WMN6TP | 2Kbit I2C SOP-8 EEPROM ROHS | D0008A_N |  |  | M24C02-WMN6TP | C7562
3 | DSUB1.385-2H9 | X5A, X5B, X5C | TE Connectivity |  | Connector; D Subminiature; 9 Position; Right Angle; Pitch 1.385 mm | DSUB1.385-2H9 |  |  | DSUB1.385-2H9 | C141882
3 | SG-8018CE 8.1920M | Y1A, Y1B, Y1C |  | SG-8018CE 8.1920M | 8.192 MHz XO (Standard) CMOS Oscillator 1.62V ~ 3.63V Enable/Disable 4-SMD, No Lead | OSCCC320X250X120N |  |  |  | C390481
