ultrazohm/uz_d_resolver/Project Outputs for UZ_D_Resolver/Rev02/SCH_UZ_D_Resolver_Default_Rev02.PDF

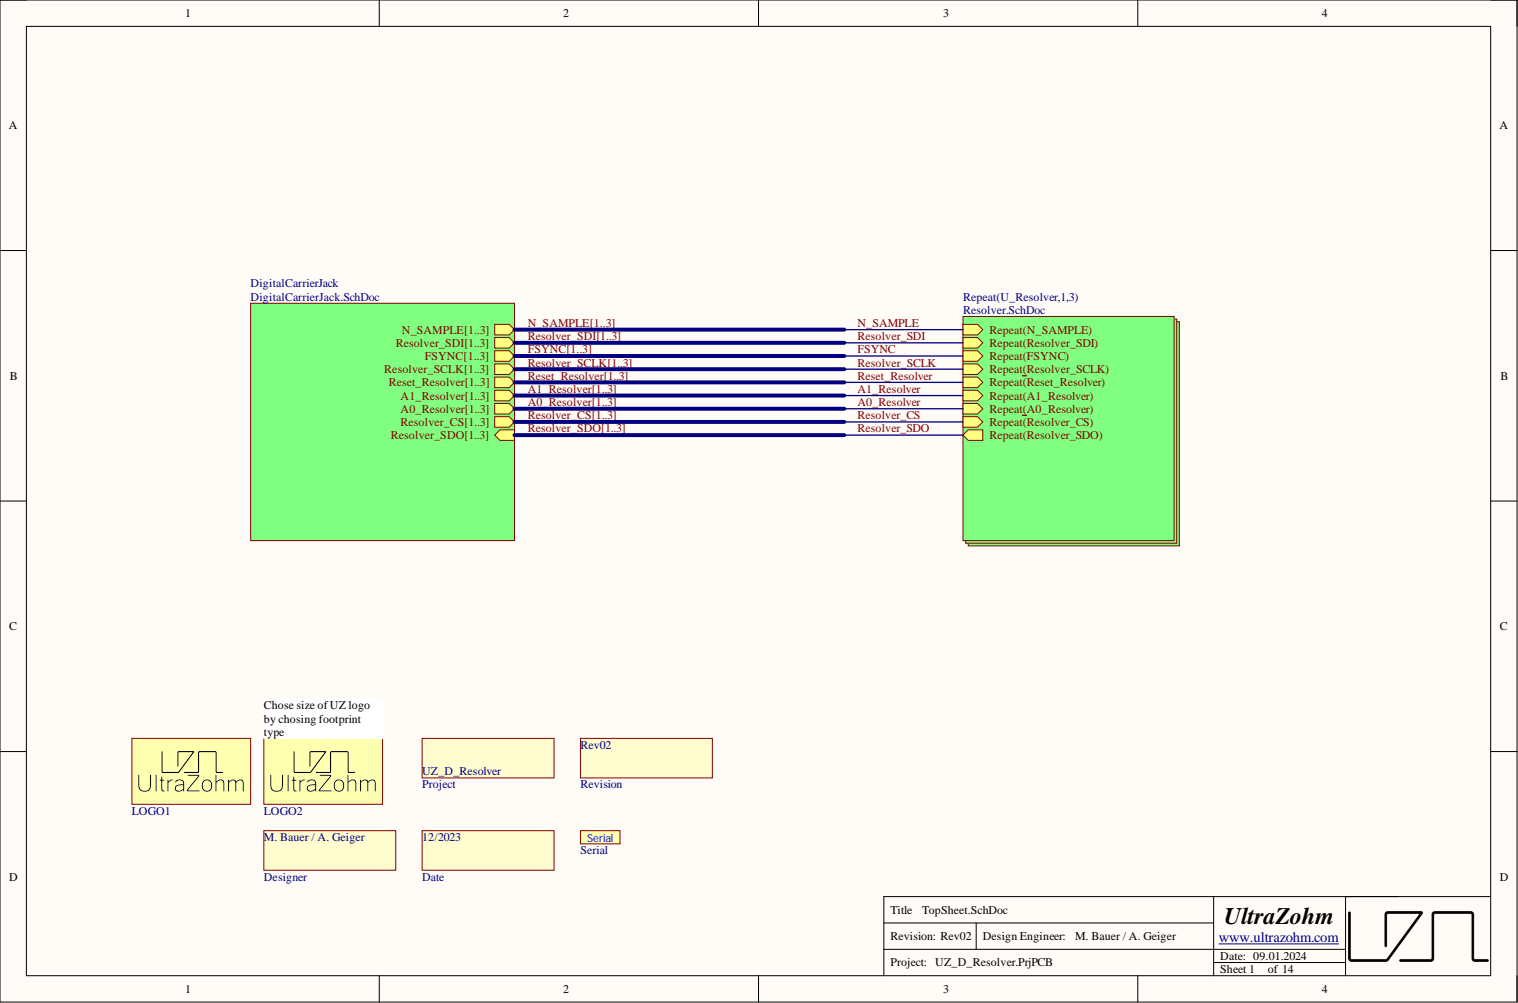
[picture p1: page 1]

Chose size of UZ logo
by chosing footprint
type

Revision:

Date: 09.01.2024

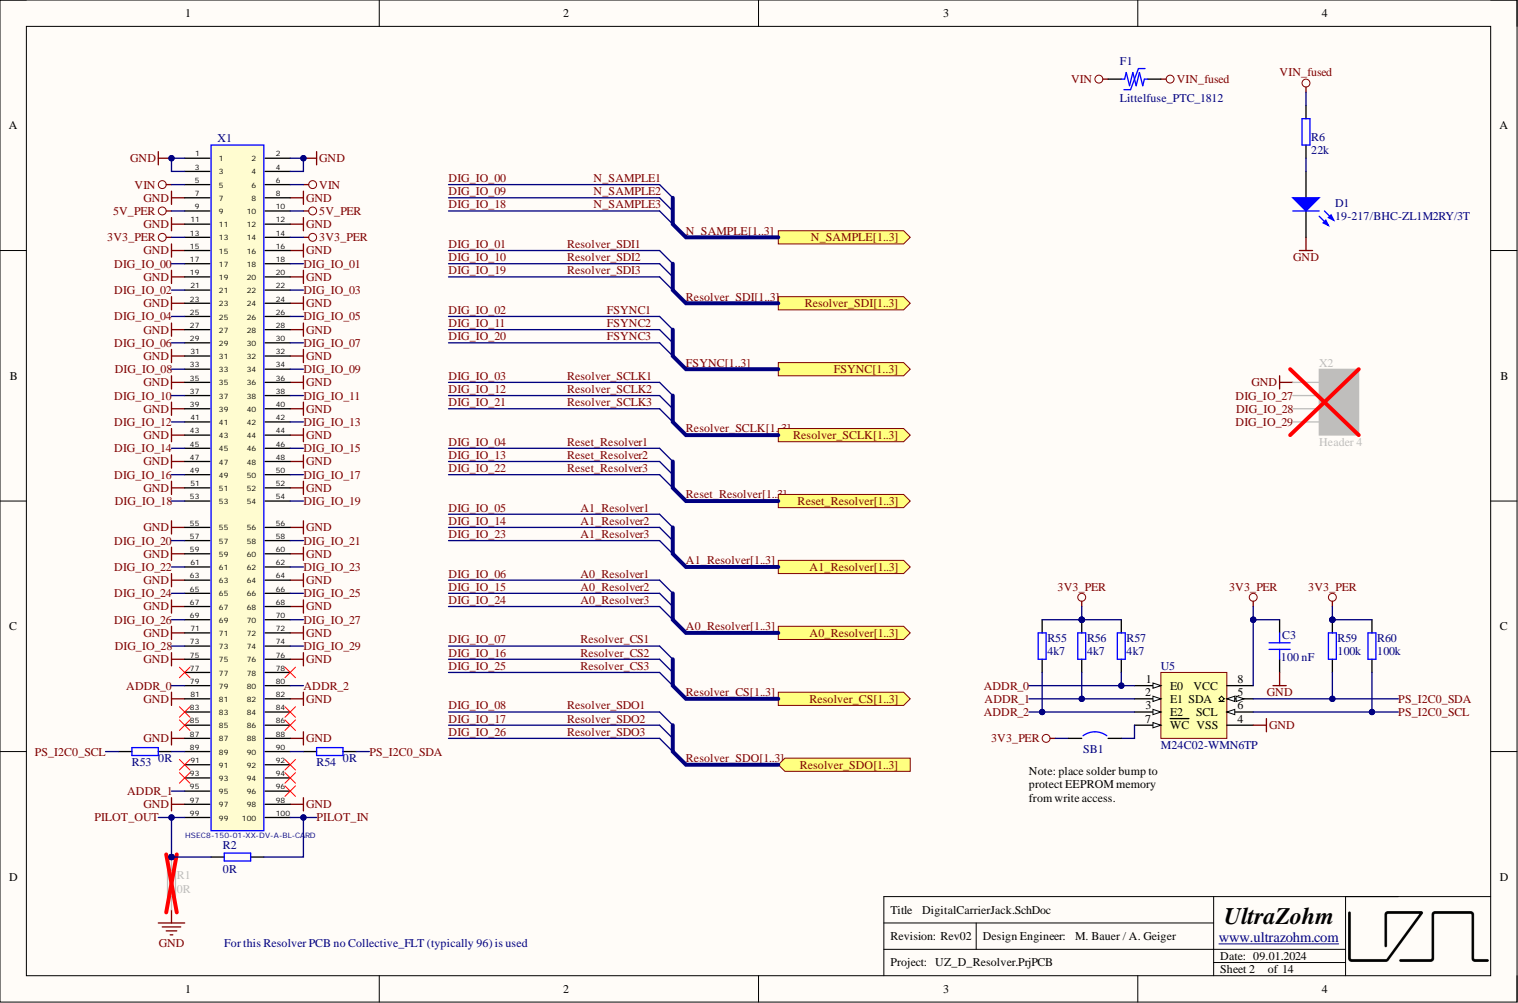
[picture p2: page 2]

Rev i s n

Dat e :

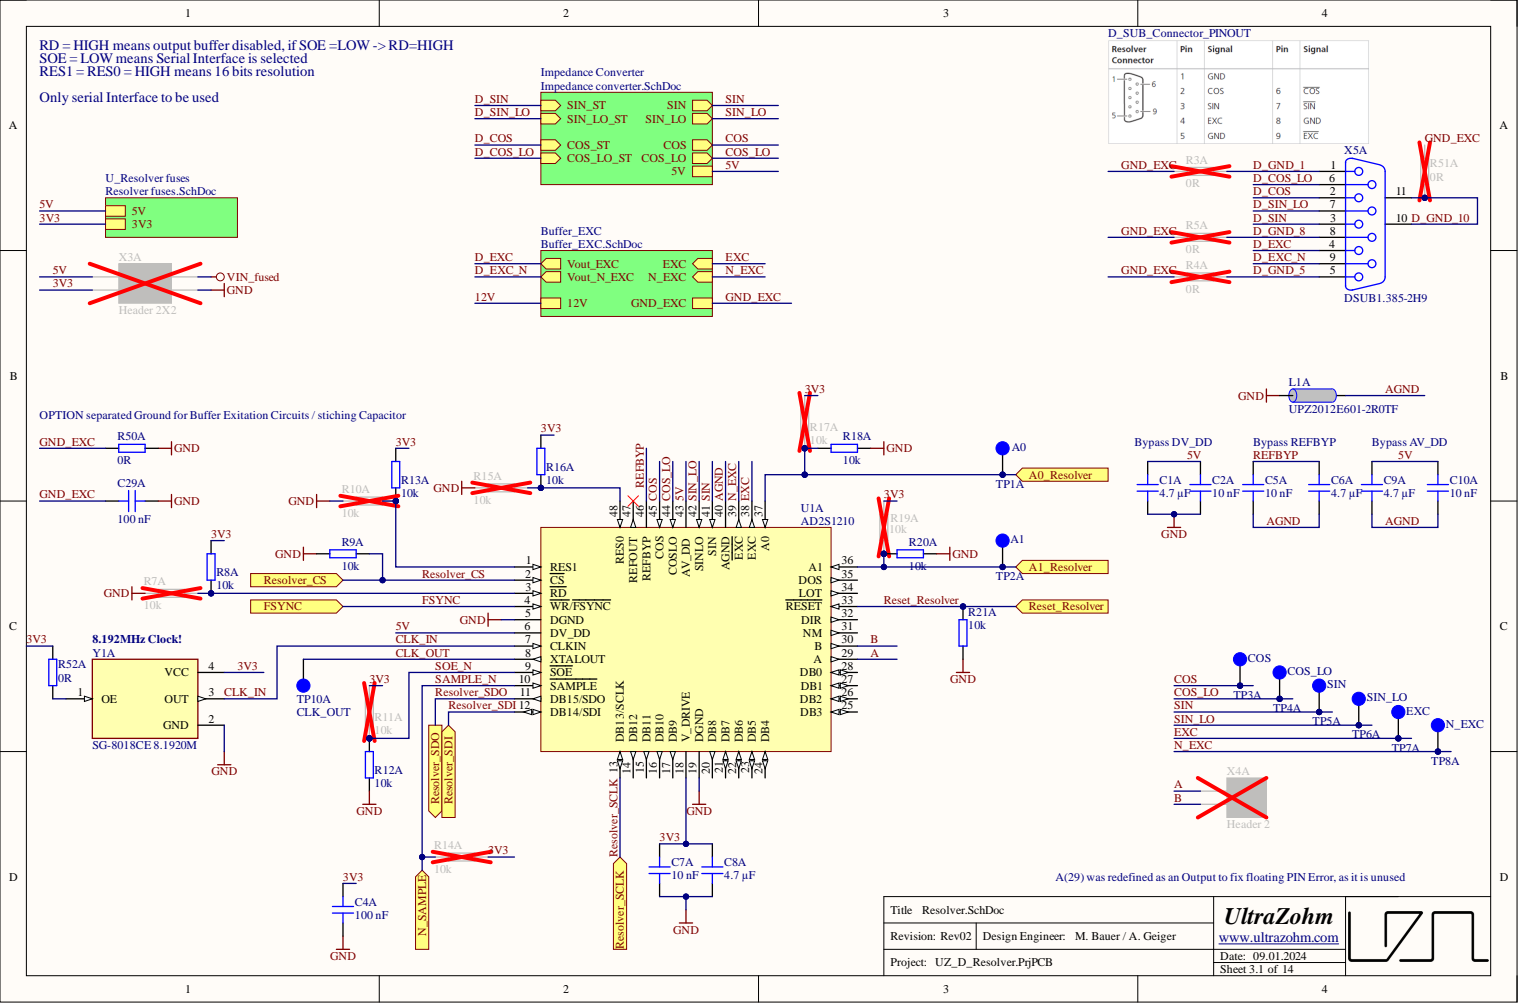
[picture p3: page 3]

RD = HIGH means output buffer disabled, if SOE =LOW -> RD=HIGH
SOE = LOW means Serial Interface is selected
RES1 = RES0 = HIGH means 16 bits resolution

Only serial Interface to be used

OPTION separated Ground for Buffer Exitation Circuits / stiching Capacitor

A0 37 EXC 38 EXC 39 AGND 40 SIN 41 SINLO 42 AV_DD 43 COSLO 44 COS 45 REFBYP 46 REFOUT 47 RES0 48

3V3 SAMPLE_N | | SAMPLE 10

Resolver_SDO | | DB15/SDO 11 | COS_LO TP3A

10k | | Resolver_SDI | DB14/SDI 12 | SIN TP4A

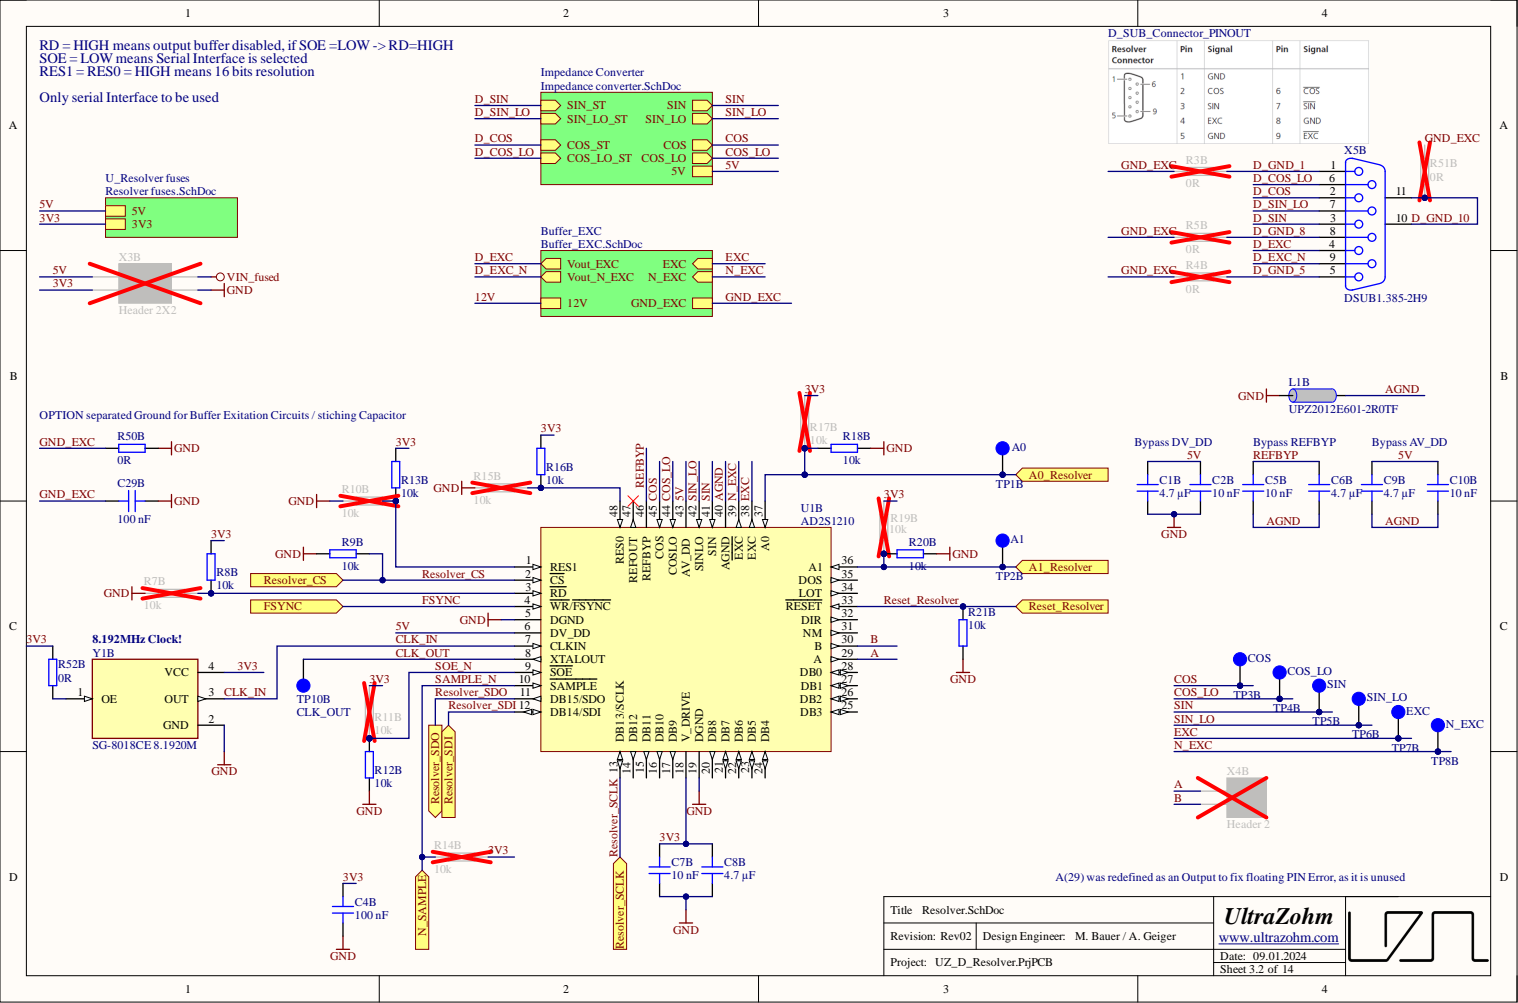
[picture p4: page 4]
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

Only serial Interface to be used

OPTION separated Ground for Buffer Exitation Circuits / stiching Capacitor

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

3V3 SAMPLE_N | | SAMPLE 10

Resolver_SDO | | DB15/SDO 11 | COS_LO TP3B

10k | | Resolver_SDI | DB14/SDI 12 | SIN TP4B

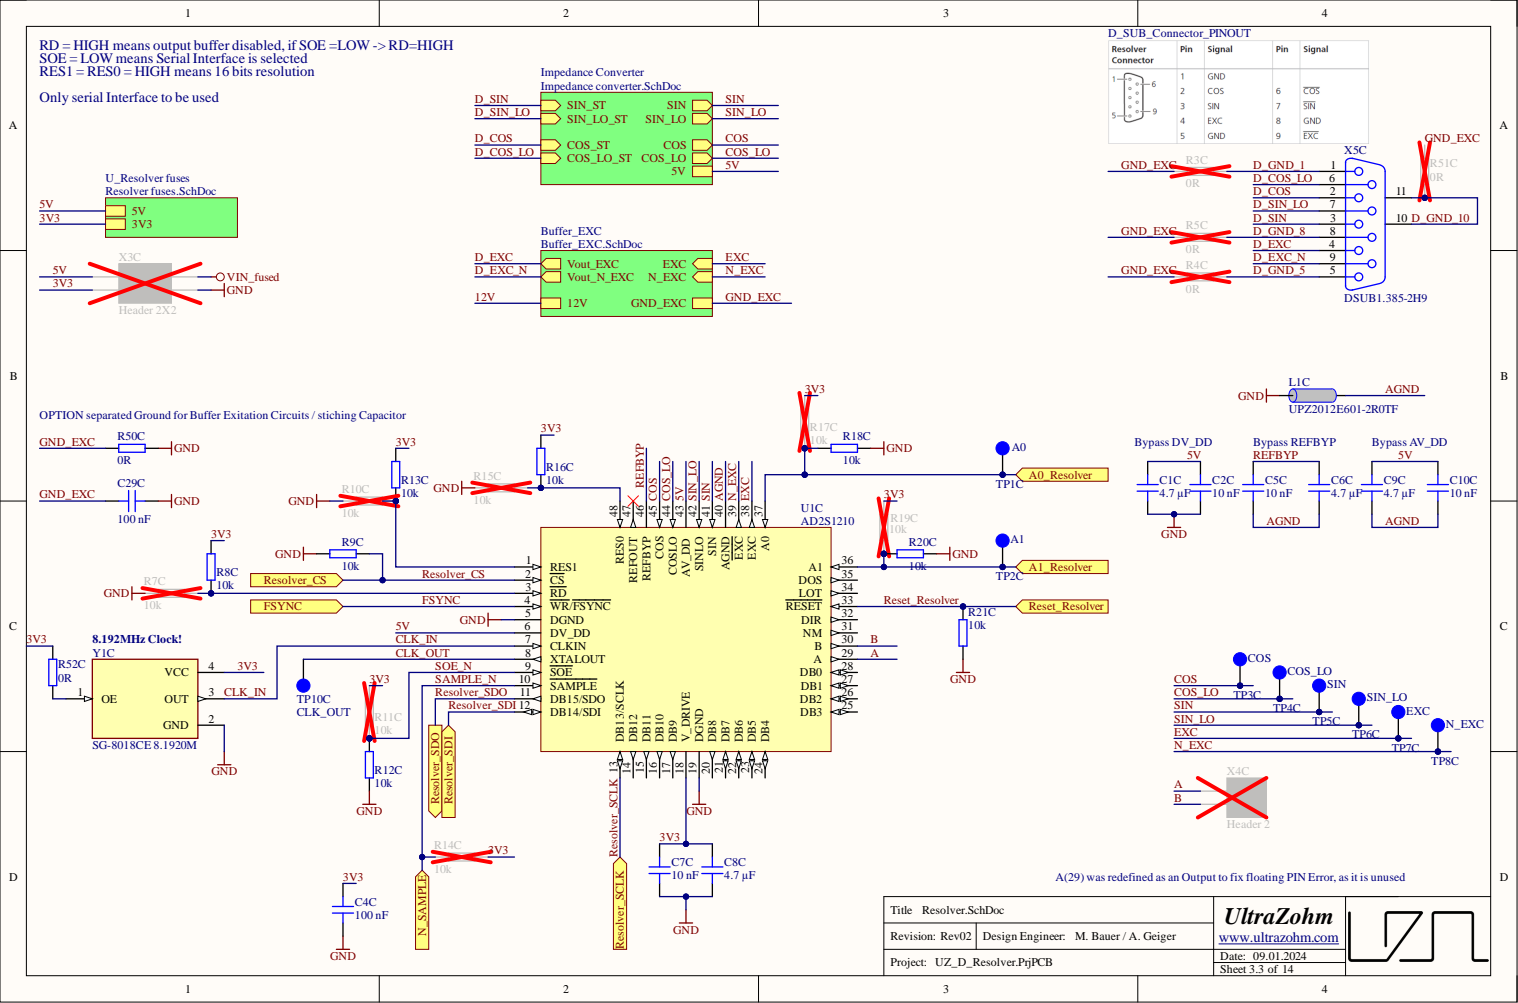
[picture p5: page 5]
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

Only serial Interface to be used

OPTION separated Ground for Buffer Exitation Circuits / stiching Capacitor

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

3V3 SAMPLE_N | | SAMPLE 10

Resolver_SDO | | DB15/SDO 11 | COS_LO TP3C

10k | | Resolver_SDI | DB14/SDI 12 | SIN TP4C

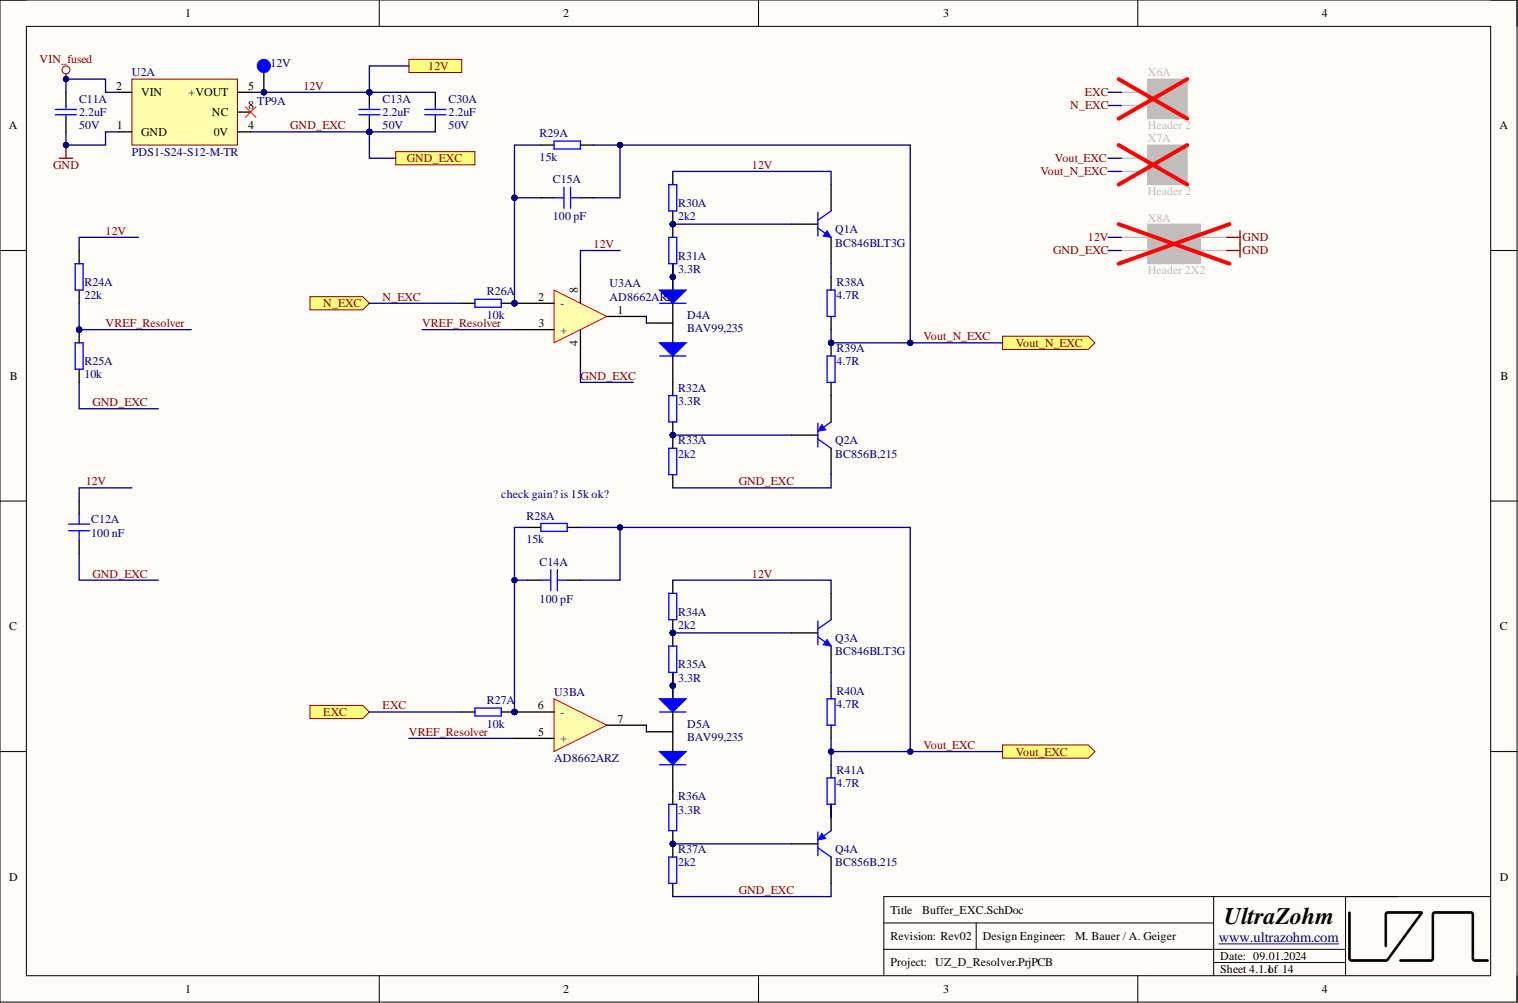
[picture p6: page 6]

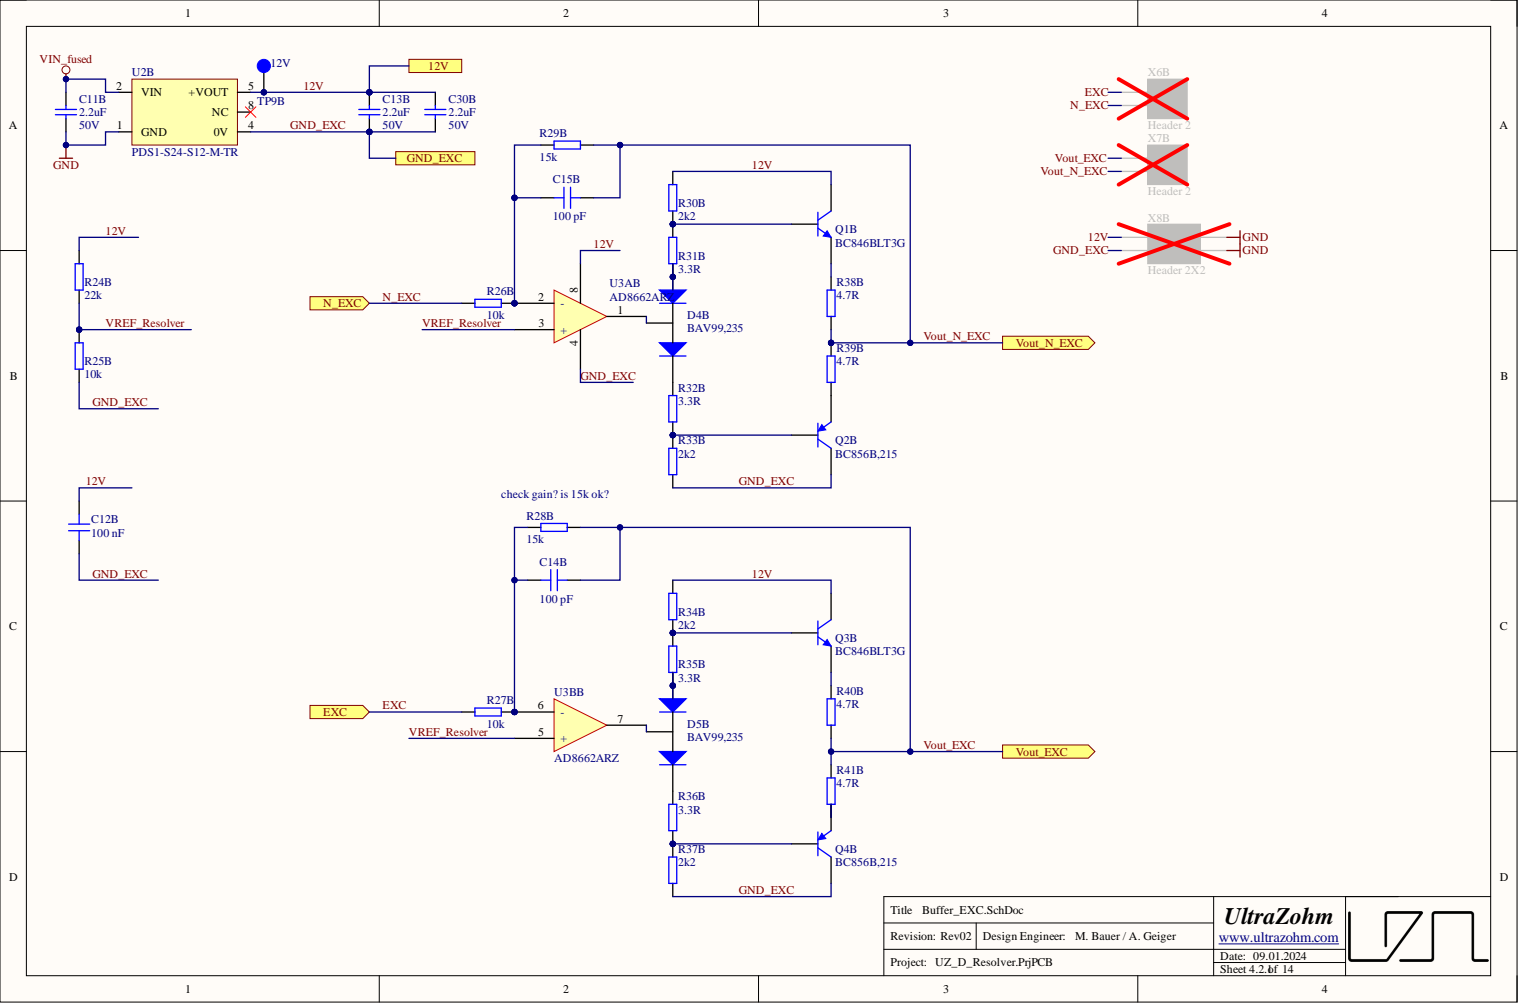
[picture p7: page 7]

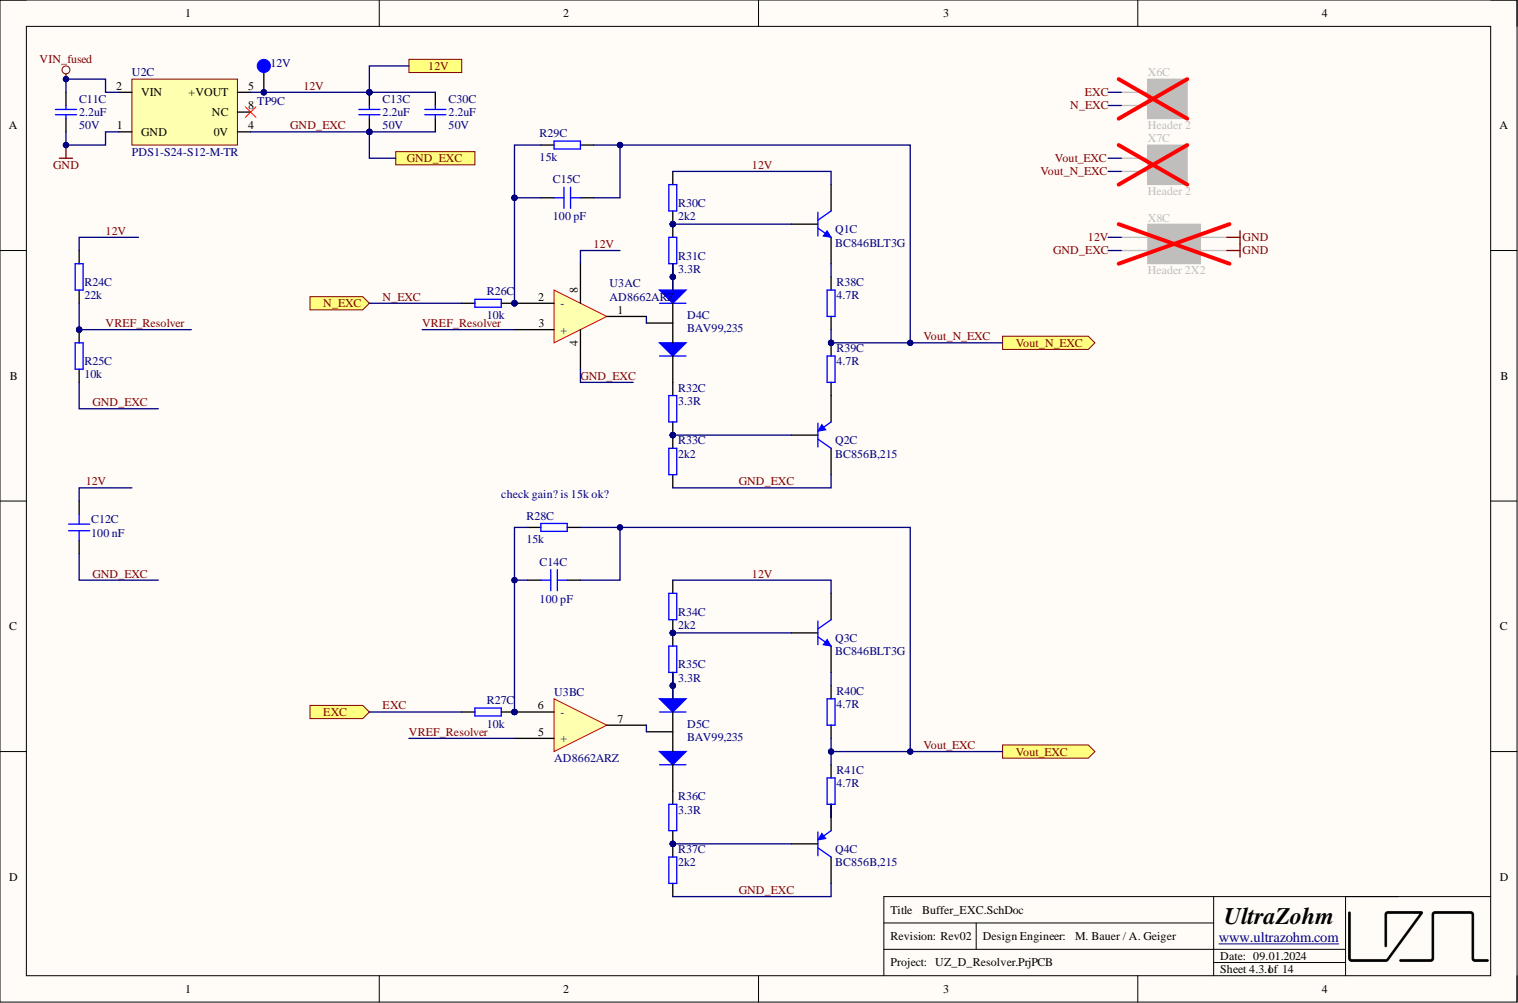
[picture p8: page 8]

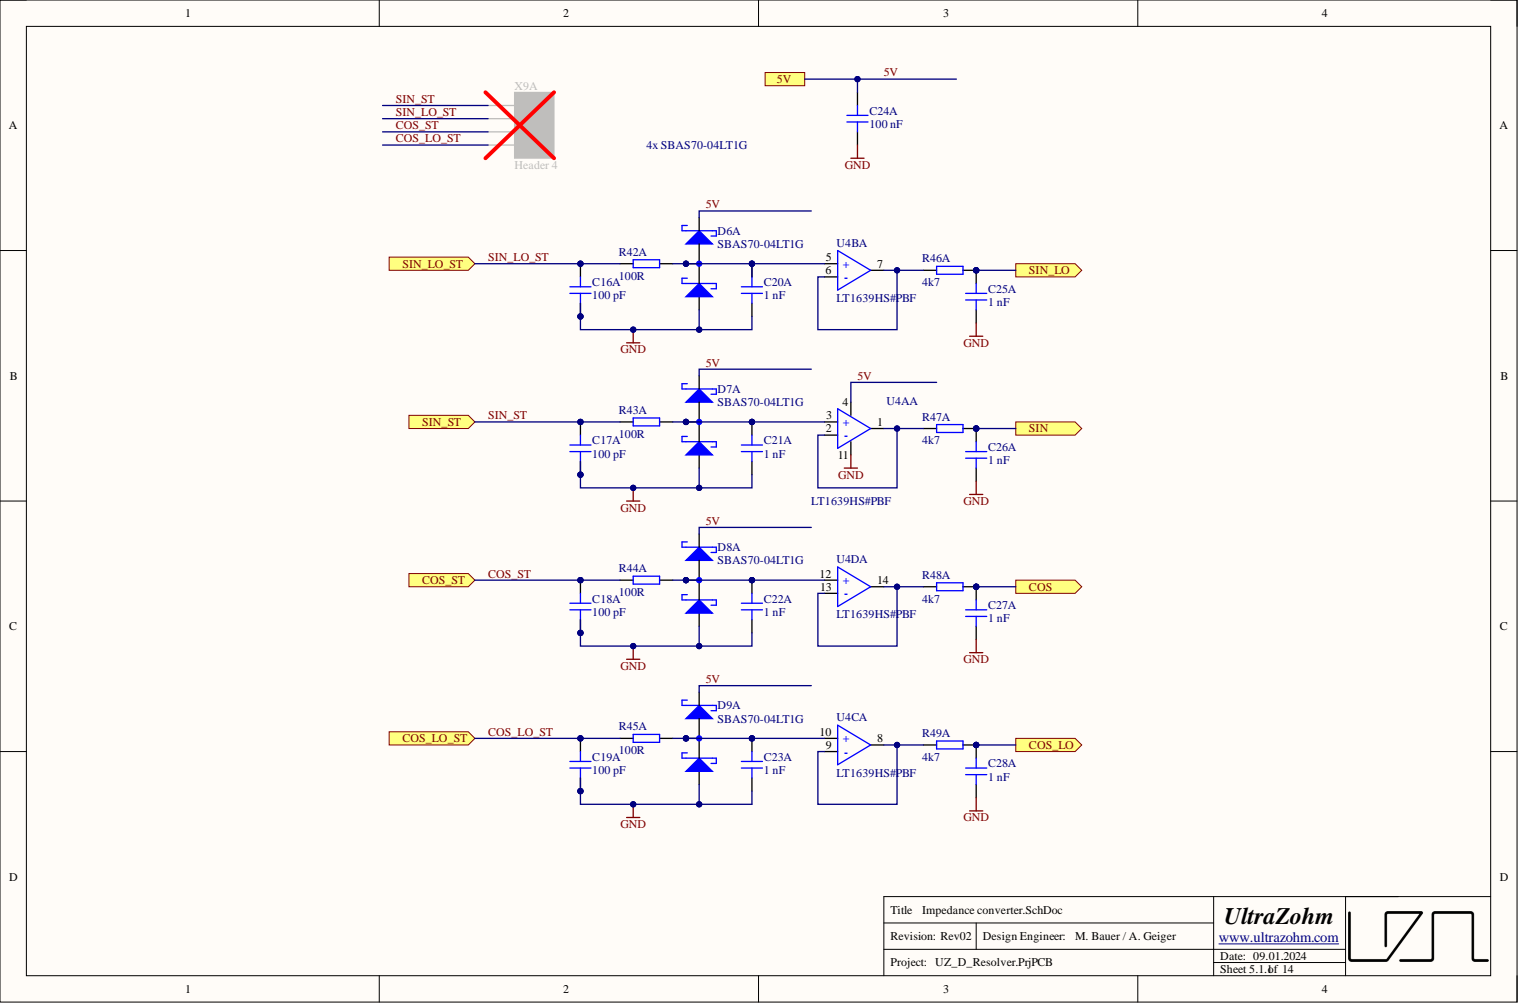
[picture p9: page 9]

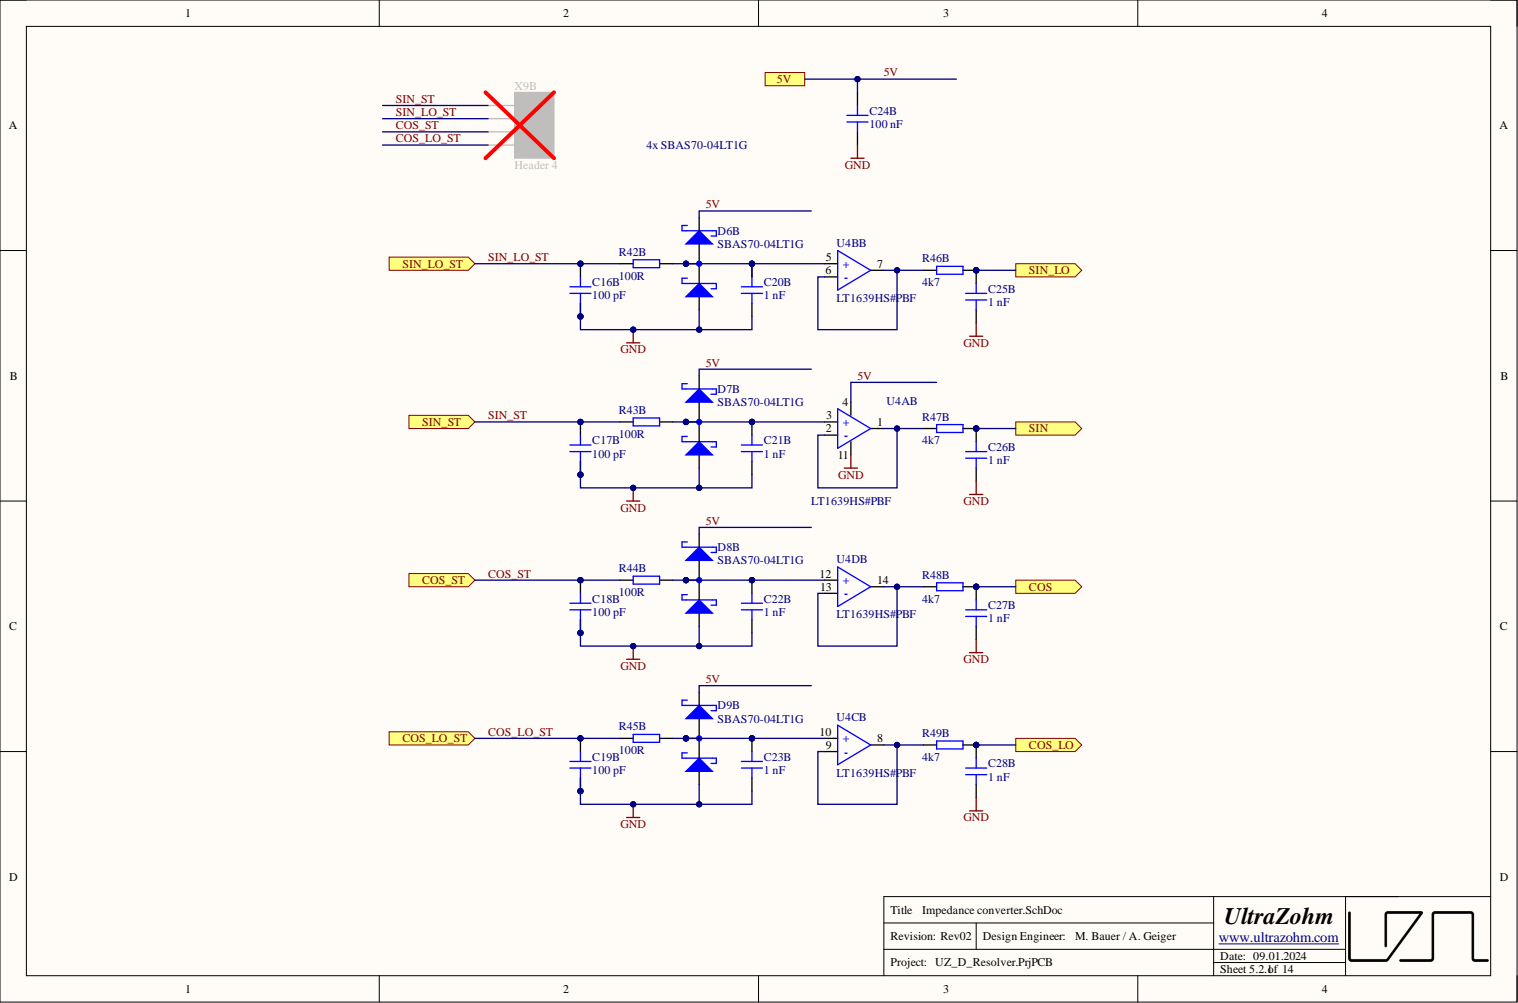
[picture p10: page 10]

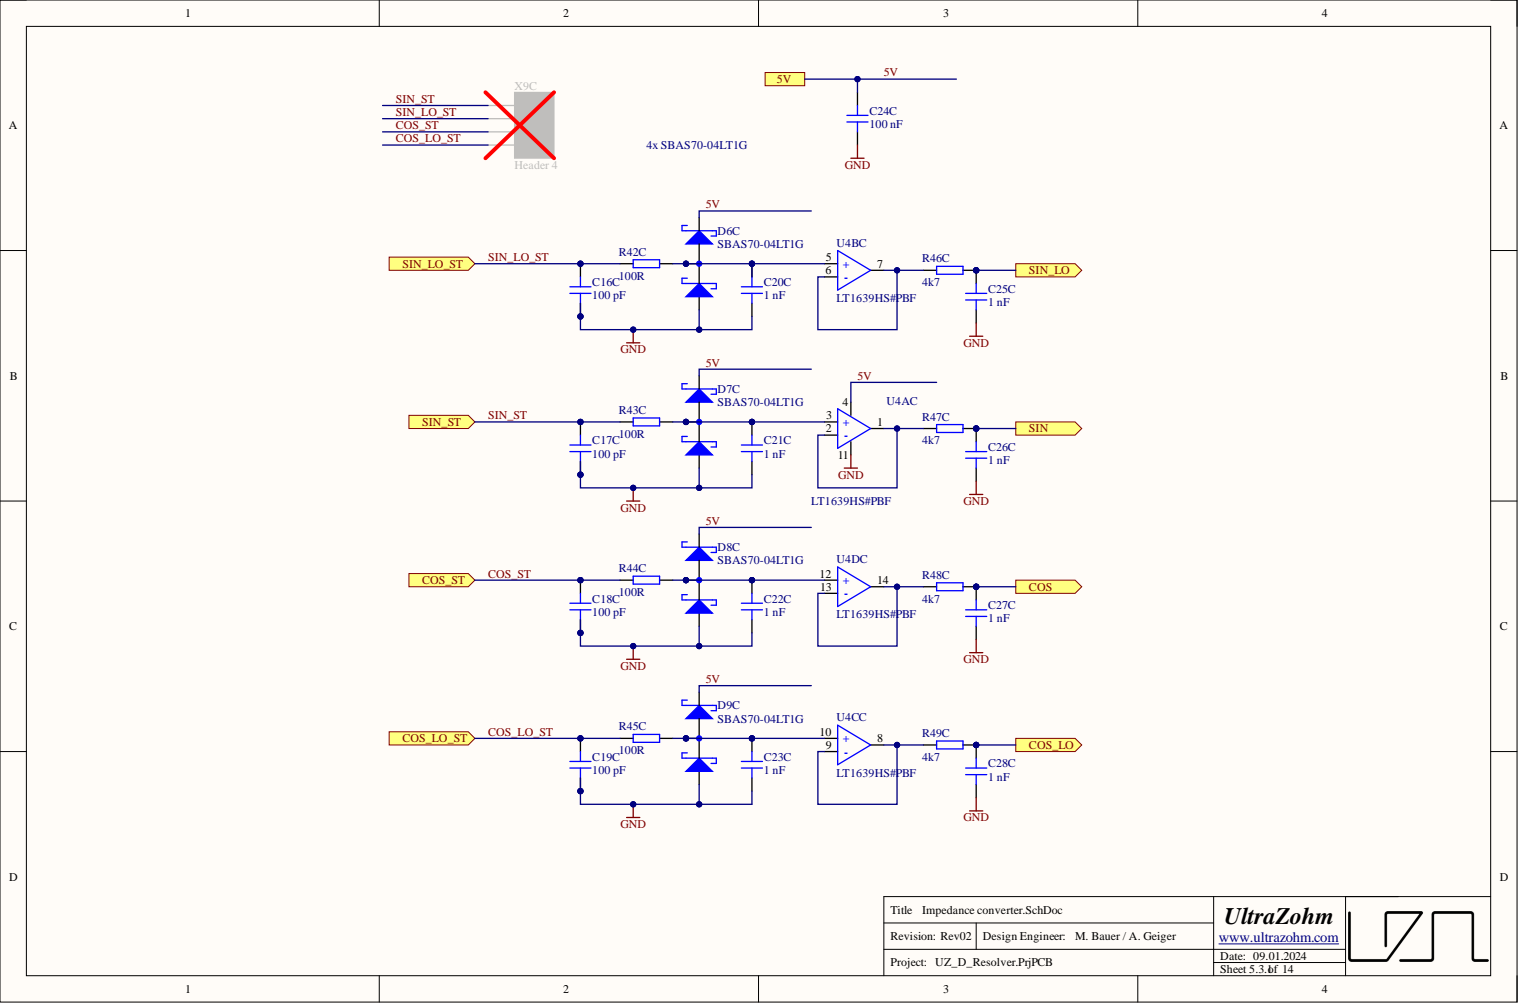
[picture p11: page 11]

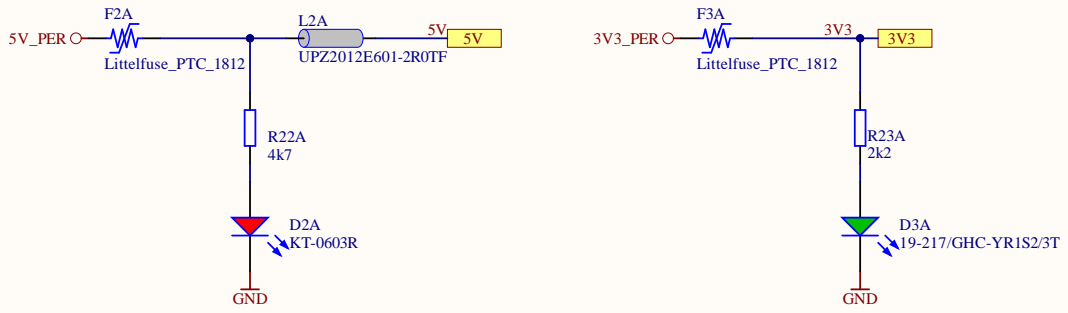
[picture p12: page 12]

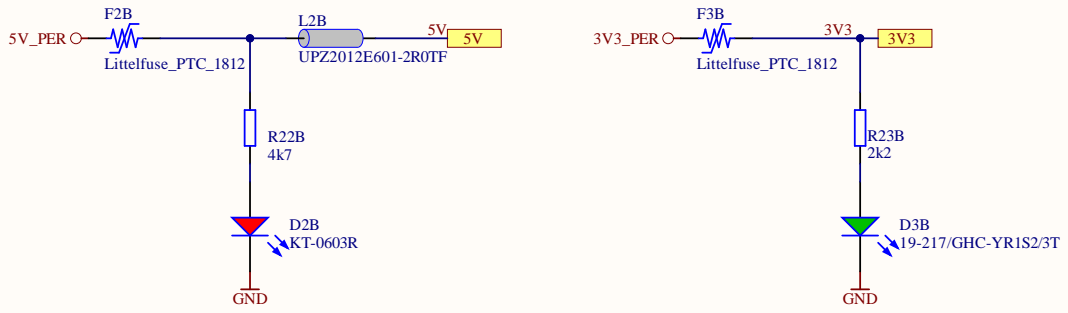
[picture p13: page 13]

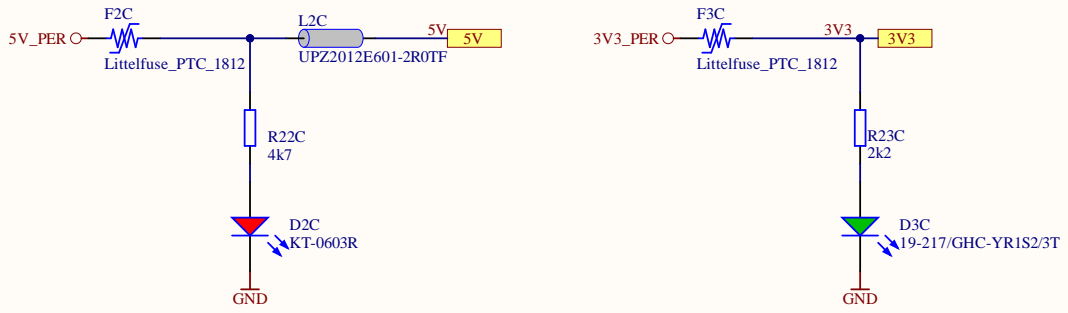
[picture p14: page 14]
