ultrazohm/uz_d_resolver/Data_Sheets/EVAL-AD2S1210_Design_Files/Top Assembly.pdf

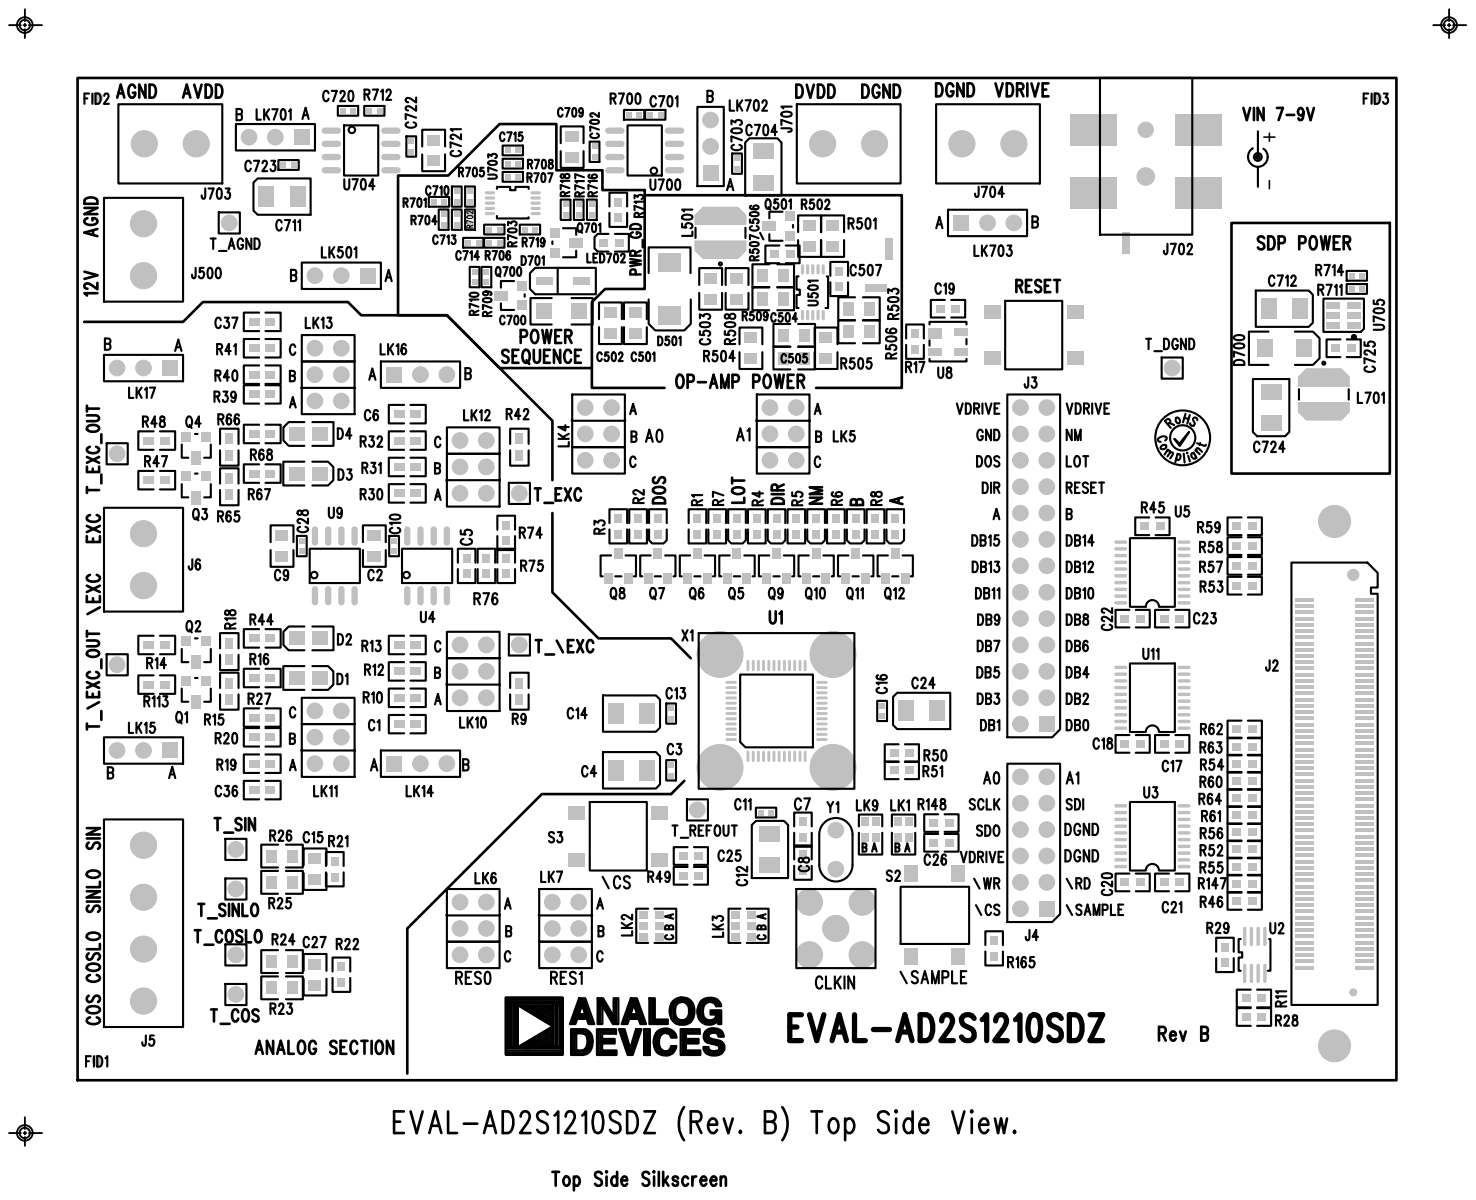
[picture p15: page 1]
