ultrazohm/uz_d_resolver/Project Outputs for UZ_D_Resolver/Rev02/ASM_UZ_D_Resolver_Default_Rev02.PDF

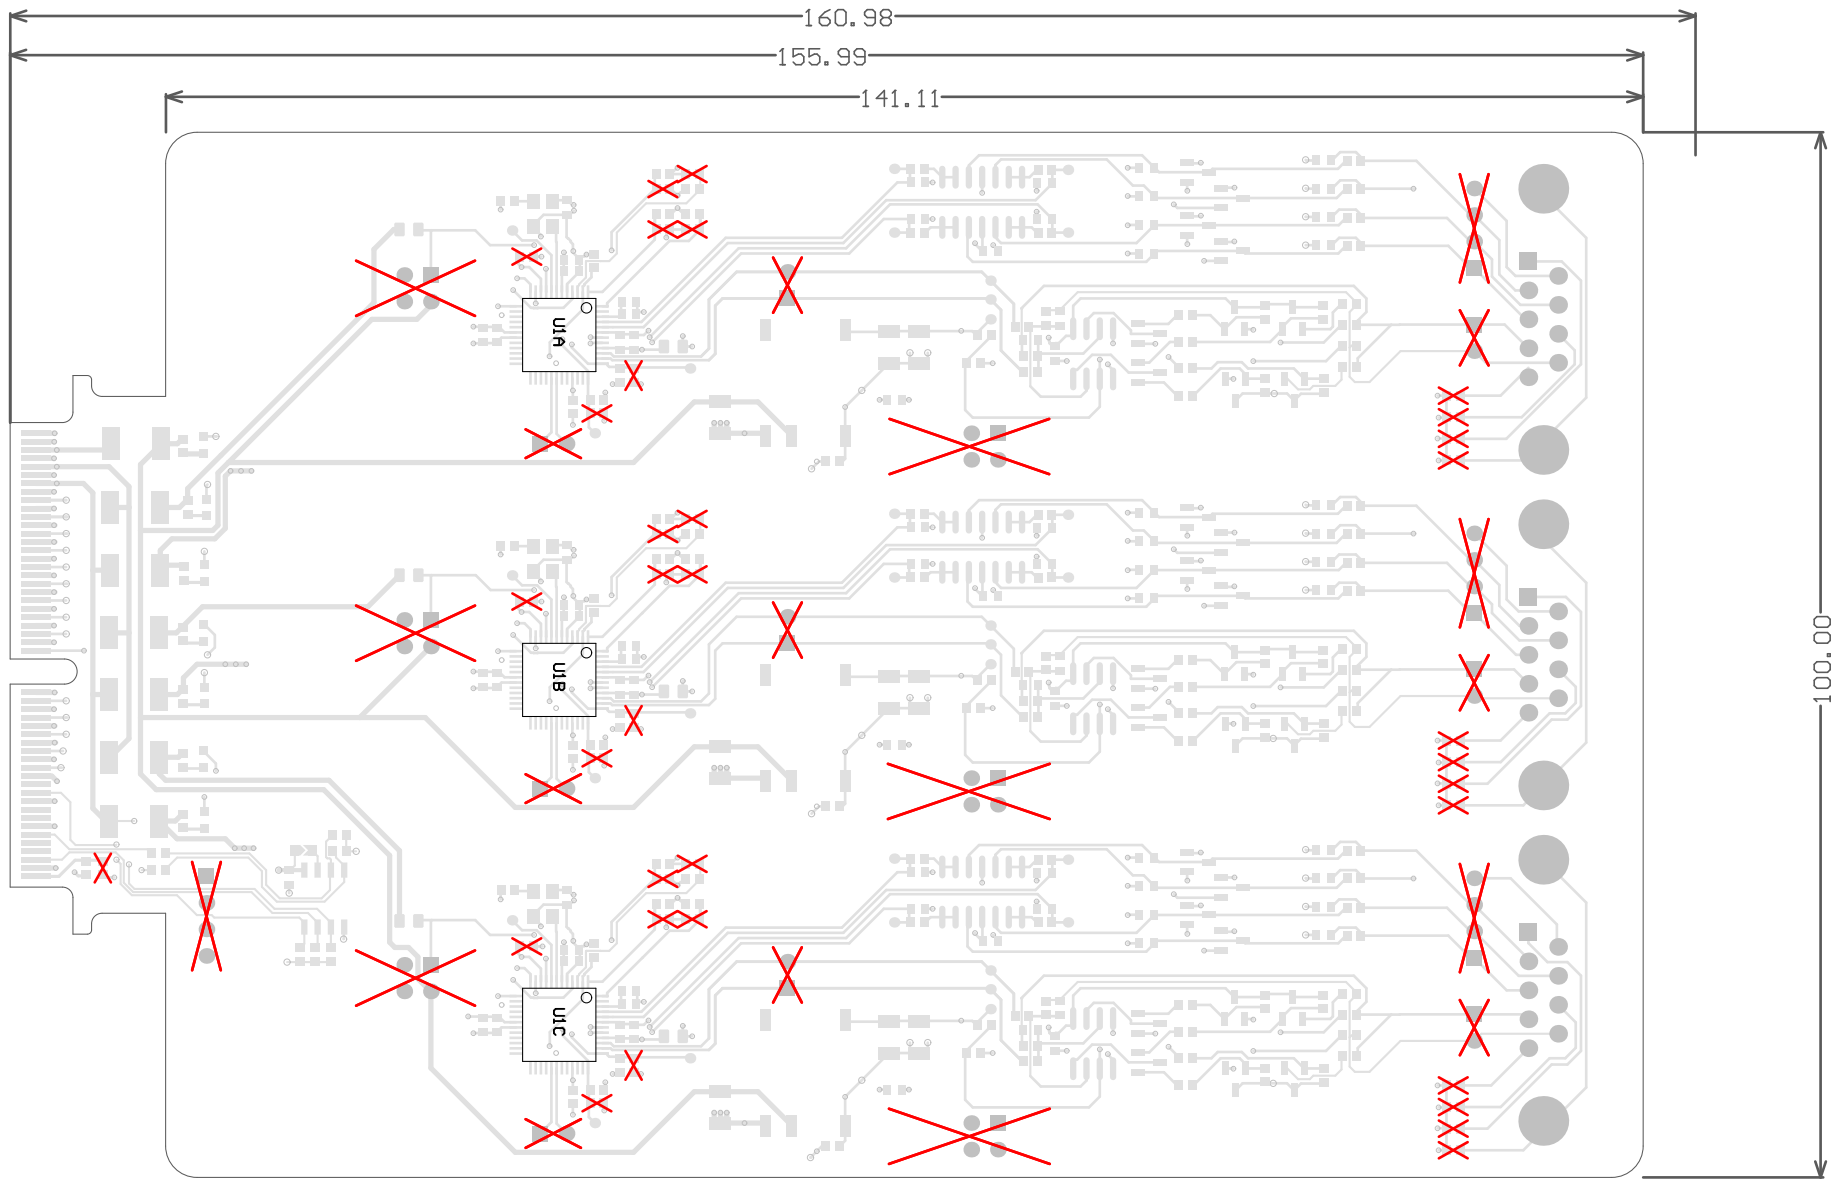
[picture p16: page 1]

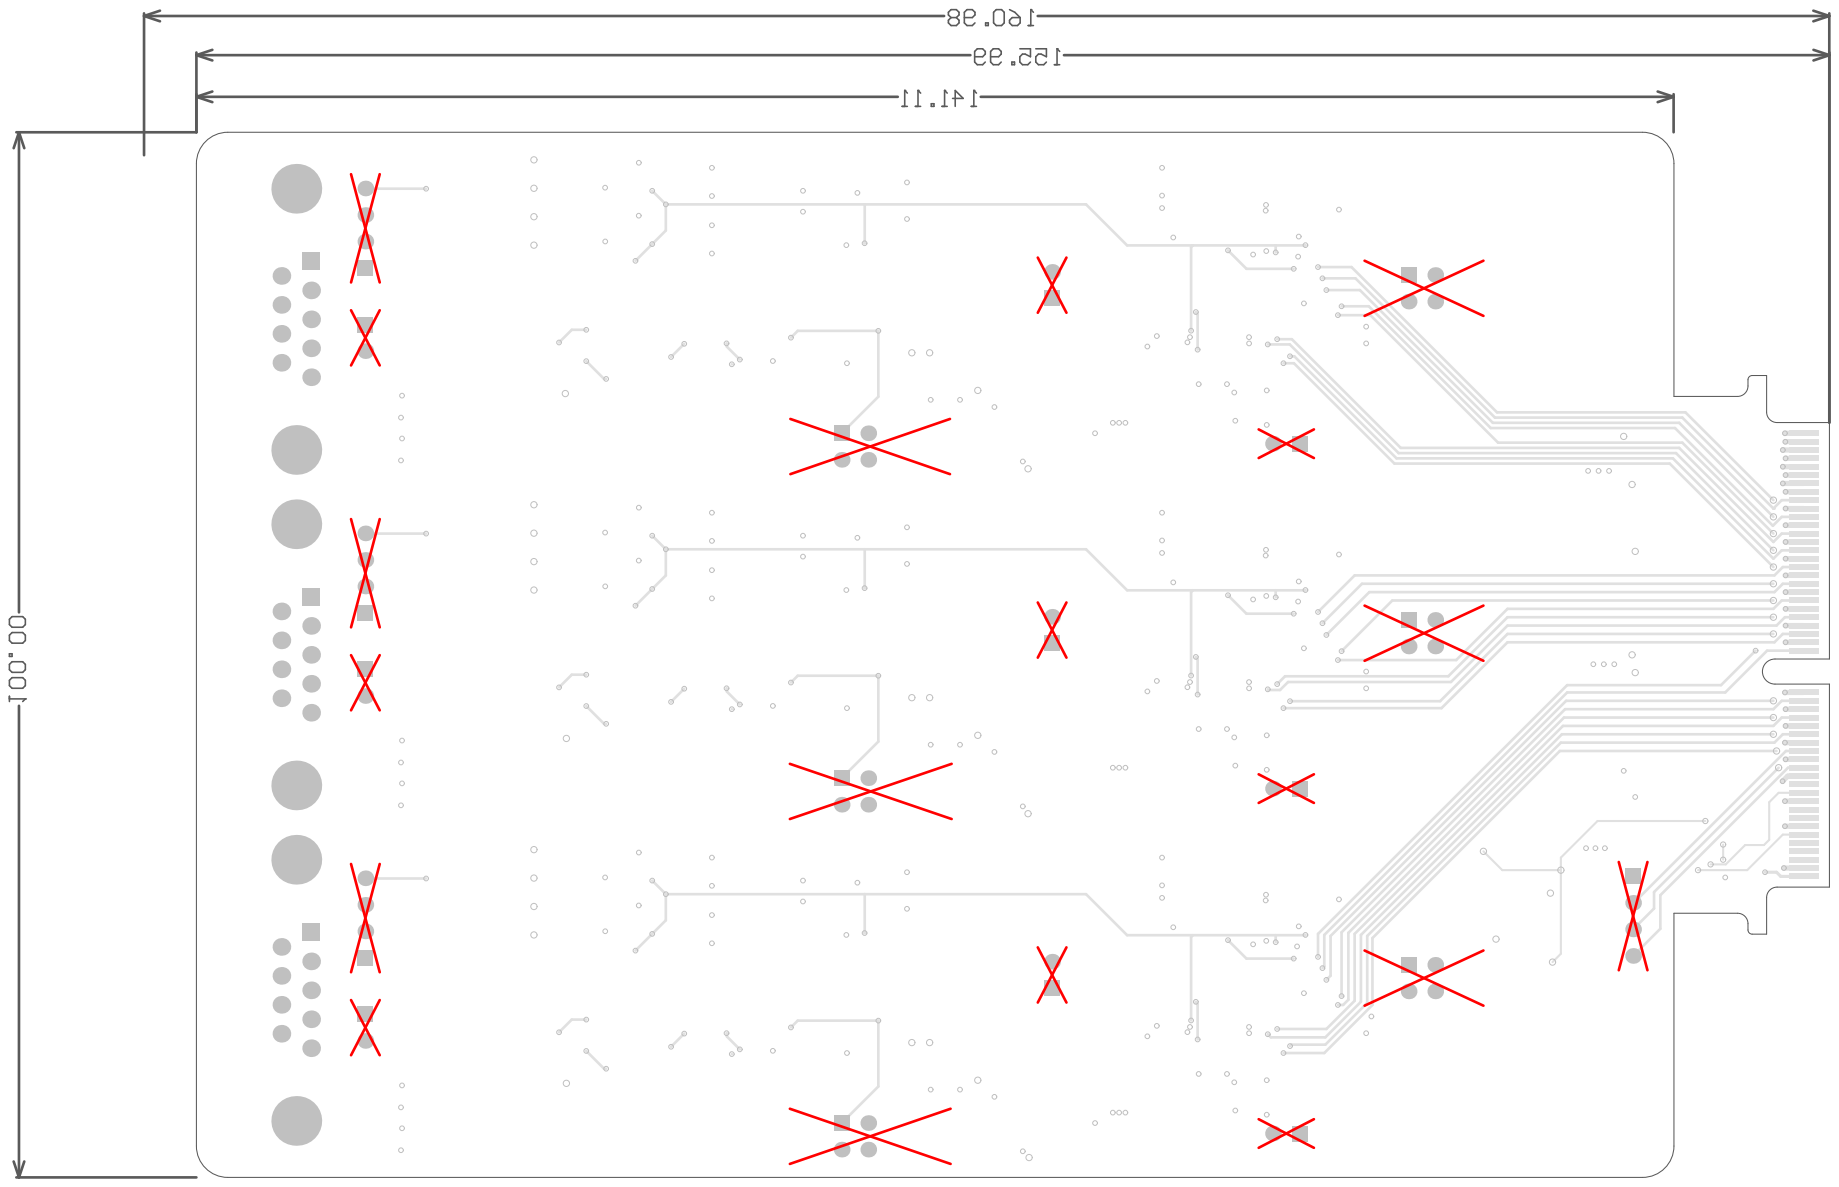
[picture p17: page 2]
