ultrazohm/uz_d_resolver/(list of files, drawings)

Other design files:
AD_AD2S1210.PcbLib
AD_AD2S1210.SchLib
Buffer_EXC.SchDoc
Componentes_SOC.SchLib
Data_Sheets/CN0276-DesignSupport/EVAL-CN0276-SDPZ-PADS-RevA.pcb
DigitalCarrierJack.SchDoc
Goldfinger_Connector.SchDoc
Impedance converter.SchDoc
Interface connector.SchDoc
LT1639CS#PBF.PcbLib
LT1639CS#PBF.SchLib
Resolver fuses.SchDoc
Resolver.PcbDoc
Resolver.SchDoc
Samtec.PcbLib
Samtec.SCHLIB
SG-8018CE_8.1920M-TJHPA0/OSCCC320X250X120N.PcbLib
SG-8018CE_8.1920M-TJHPA0/SG-8018CE_8.1920M-TJHPA0.SchLib
TopSheet.SchDoc
UltraZohm_ADC.SCHLIB
UltraZOhm_CarrierBoard.SchLib
uz_d_encoder_lib.PcbLib
uz_d_encoder_lib.SchLib
UZ_D_Resolver.PrjPCB
UZohmADC.PcbLib
