ultrazohm/uz_d_resolver/(commit log)

2022-11-15 added uz_d_template files to repo
    [DigitalCarrierJack.SchDoc, TopSheet.SchDoc, UZ_D_Template.PcbDoc, UZ_D_Template.PrjPCB]
2022-12-18 First Additions, creating schematics
    [AD_AD2S1210.PcbLib, AD_AD2S1210.SchLib, Buffer_EXC.SchDoc, Componentes_SOC.SchLib, DigitalCarrierJack.SchDoc, Goldfinger_Connector.SchDoc, Impedance converter.SchDoc, Interface connector.SchDoc]
2022-12-19 Additions to Schematic, cleaning up errors
    [Buffer_EXC.SchDoc, DigitalCarrierJack.SchDoc, Impedance converter.SchDoc, Resolver.PcbDoc, Resolver.SchDoc, TopSheet.SchDoc, UZ_D_Template.PcbDoc, UZ_D_Template.PrjPCB]
2022-12-22 Adding D Sub and OP Amp LT1639CS (temporary)
    [Buffer_EXC.SchDoc, DigitalCarrierJack.SchDoc, Impedance converter.SchDoc, LT1639CS#PBF.PcbLib, LT1639CS#PBF.SchLib, Resolver.SchDoc, TopSheet.SchDoc, UZ_D_Template.PrjPCB]
2022-12-29 Starting PCB Layout & Schematic updated
    [Buffer_EXC.SchDoc, DigitalCarrierJack.SchDoc, Impedance converter.SchDoc, Resolver.SchDoc, TopSheet.SchDoc]
2023-01-06 PCB completed for one Resolver circuit using Repeat (interim status)
    [DigitalCarrierJack.SchDoc]
2023-01-11 Adding all 3 channels to project
    [Buffer_EXC.SchDoc, DigitalCarrierJack.SchDoc, Resolver.SchDoc, UZ_D_Template.PrjPCB]
2023-01-15 Finished Rooting and separated Channels A..C
    [Buffer_EXC.SchDoc, DigitalCarrierJack.SchDoc, Impedance converter.SchDoc, Resolver.SchDoc, TopSheet.SchDoc, UZ_D_Resolver.PrjPCB, UZ_D_Template.PrjPCB]
2023-01-20 Cleanup, Rev1.00
    [TopSheet.SchDoc, UZ_D_Resolver.PrjPCB]
2023-01-23 Corrections, to Rev1.00 - Fuses on Resolver Sheets, Fixed Grids
    [Buffer_EXC.SchDoc, DigitalCarrierJack.SchDoc, Impedance converter.SchDoc, Resolver.SchDoc, TopSheet.SchDoc, UZ_D_Resolver.PrjPCB]
2023-01-24 Corrections to Rev 1.00 - Positions of DSub Ports, Addition of Default Variant and UZ Logo
    [BOM_UZ_D_Resolver_Rev01.xlsx, DigitalCarrierJack.SchDoc, Resolver.SchDoc, TopSheet.SchDoc, UZ_D_Resolver.PrjPCB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]
2023-01-25 - stop tracking previews and history and fix gitignore - first clean up steps of schematics as stated in slack
    [Buffer_EXC.SchDoc, DigitalCarrierJack.SchDoc, Impedance converter.SchDoc, Resolver.SchDoc, TopSheet.SchDoc]
2023-01-25 first steps on pcb as discussed in slack
2023-01-25 Corrections to Rev 1 - Adding separate pin headers for channels, improving component placement, cleaning up Schematic
    [Buffer_EXC.SchDoc, DigitalCarrierJack.SchDoc, Resolver.SchDoc, TopSheet.SchDoc, UZ_D_Resolver.PrjPCB]
2023-01-26 - add additional test points - add 0R for GND on DSUB9 - update sheet numbering
    [Buffer_EXC.SchDoc, DigitalCarrierJack.SchDoc, Impedance converter.SchDoc, Resolver.SchDoc, TopSheet.SchDoc, UZ_D_Resolver.PrjPCB]
2023-01-26 as discussed on zoom
    [Buffer_EXC.SchDoc, Resolver.SchDoc, UZ_D_Resolver.PrjPCB]
2023-01-26 Adding separate sheet for Resolver 3V3 and 5V Fuses, updating sheet numbering
    [Buffer_EXC.SchDoc, DigitalCarrierJack.SchDoc, Impedance converter.SchDoc, Resolver fuses.SchDoc, Resolver.SchDoc, TopSheet.SchDoc, UZ_D_Resolver.PrjPCB]
2023-01-27 Rework for Channel Design, correcting the placement of bypass capacitors (WIP)
2023-01-27 Finishing Channel Design Rework, adding Polygon cutout beneath Clock
    [UZ_D_Resolver.PrjPCB]
2023-01-27 Improving Polygons, placement of EXC Jumper, vias; Adding Text and correcting BS1 to GND and AGND
    [Impedance converter.SchDoc, Resolver.SchDoc, UZ_D_Resolver.PrjPCB]
2023-01-29 moved components at lower pcb edge in order to give more space to the 2mm constraint zone, renamed 12V probe pins to ABC, before was AAA. Moved UZ and serial logo to more proper places
2023-01-30 - improve routing of Channel B - clean up resolver sheet - add more capacitance to isolated 12V
    [Buffer_EXC.SchDoc, DigitalCarrierJack.SchDoc, Resolver.SchDoc]
2023-01-30 fix pcb outline on m1, 0.001mm offset
2023-01-31 fix pcb annotations, like UZ logo, designer, etc
    [TopSheet.SchDoc, UZ_D_Resolver.PrjPCB]
2023-01-31 fix C12
    [Buffer_EXC.SchDoc, DigitalCarrierJack.SchDoc, Resolver.SchDoc, UZ_D_Resolver.PrjPCB]
2023-01-31 first steps towards jlc
    [Buffer_EXC.SchDoc, DigitalCarrierJack.SchDoc, Resolver.SchDoc, UZ_D_Resolver.PrjPCB]
2023-01-31 second steps towards jlc assembly
    [Buffer_EXC.SchDoc, DigitalCarrierJack.SchDoc, Impedance converter.SchDoc, Resolver.SchDoc, UZ_D_Resolver.PrjPCB]
2023-02-01 wip to jlc assembly
    [Buffer_EXC.SchDoc, DigitalCarrierJack.SchDoc, Impedance converter.SchDoc, Resolver fuses.SchDoc, Resolver.SchDoc]
2023-02-01 added new clock
    [Buffer_EXC.SchDoc, DigitalCarrierJack.SchDoc, OSCCC320X250X120N.PcbLib, Resolver.SchDoc, SG-8018CE_8.1920M-TJHPA0.SchLib, UZ_D_Resolver.PrjPCB]
2023-02-01 before deleting old clock
    [Resolver.SchDoc]
2023-02-01 alle jlc sachen angepasst für bestellung, routing ist WIP!
    [Impedance converter.SchDoc, Resolver.SchDoc]
2023-02-02 - final touches on pcb rules and drc - clean up folder files
    [BOM_UZ_D_Resolver_Rev01.xlsx, UZ_D_Resolver.PrjPCB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]
2023-02-20 - fix pull-up on N_SAMPLE to be tied to 3V3 - close Issue #1
    [Resolver.SchDoc, UZ_D_Resolver.PrjPCB]
2023-02-20 add production files for Rev01
    [BOM_JLC-UZ_D_Resolver(Default).xlsx, Pick Place for UltraZohm_Digital_Resolver(Default).csv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]
2023-02-20 add additional design resources from AD
    [EVAL-AD2S1210SDZ BOM Rev B.xlsx, EVAL-CN0276-SDPZ-BOM-RevA.xlsx, EVAL-CN0276-SDPZ-PADS-RevA.pcb, EVAL-CN0276-SDPZ-SCH-RevA.sch]
2023-09-01 added excel sheet with test of rounds per second value
    [resolver_rps_factor.xlsx]
2023-12-24 add EEPROM
    [DigitalCarrierJack.SchDoc]
2023-12-25 annotate all parts; change connectors designators from J* to X*
    [Buffer_EXC.SchDoc, DigitalCarrierJack.SchDoc, Impedance converter.SchDoc, Resolver.SchDoc, UZ_D_Resolver.PrjPCB]
2023-12-25 routing of EEPROM signals
    [DigitalCarrierJack.SchDoc, UZ_D_Resolver.PrjPCB]
2023-12-25 shifted both outer DSUB-9 connectors by 1.5 mm away from middle connector
2023-12-29 shifted connectors back to initial position
2023-12-29 generate production files and documentary files
    [BOM_JLC-UZ_D_Resolver(Default).xlsx, Pick Place for UltraZohm_Digital_Resolver(Default).csv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]
2023-12-29 added jlc bom with missing part numbers
    [BOM_JLC-UZ_D_Resolver(Default)_w_JLC_part_no.xlsx]
2024-01-02 jlc nummern angepasst
    [BOM_JLC-UZ_D_Resolver(Default)_w_JLC_part_no.xlsx]
2024-01-09 add solder bumper instead of pull-up at EEPROM write access protection pin; generate production files
    [BOM_JLC-UZ_D_Resolver(Default).xlsx, DigitalCarrierJack.SchDoc, Pick Place for UltraZohm_Digital_Resolver(Default).csv, UZ_D_Resolver.PrjPCB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]
2024-01-25 lcsc nummern nachgetragen, in library soweit verfügbar oder sonst im schematic
    [Buffer_EXC.SchDoc, Impedance converter.SchDoc, Resolver.SchDoc, UZ_D_Resolver.PrjPCB]
2024-08-22 modified BOM for Reorder (FR)
    [BOM_JLC-UZ_D_Resolver_FR.xlsx]
2024-08-24 bom namen angepasst und C Nummer angepasst für
    - U1 -> AD2S1210WDSTZRL7
    - U4 -> LT1639HS
    [BOM_JLC-UZ_D_Resolver(Default).xlsx, BOM_JLC-UZ_D_Resolver_August_2024.xlsx, BOM_JLC-UZ_D_Resolver_FR.xlsx, BOM_JLC-UZ_D_Resolver_Jan_2024.xlsx]
